ETML-ES-SLO/PRJ_2409_Surveillance_T_H_Frigo/doc/Annexes/Annexes non triés/Annexe K à N.pdf

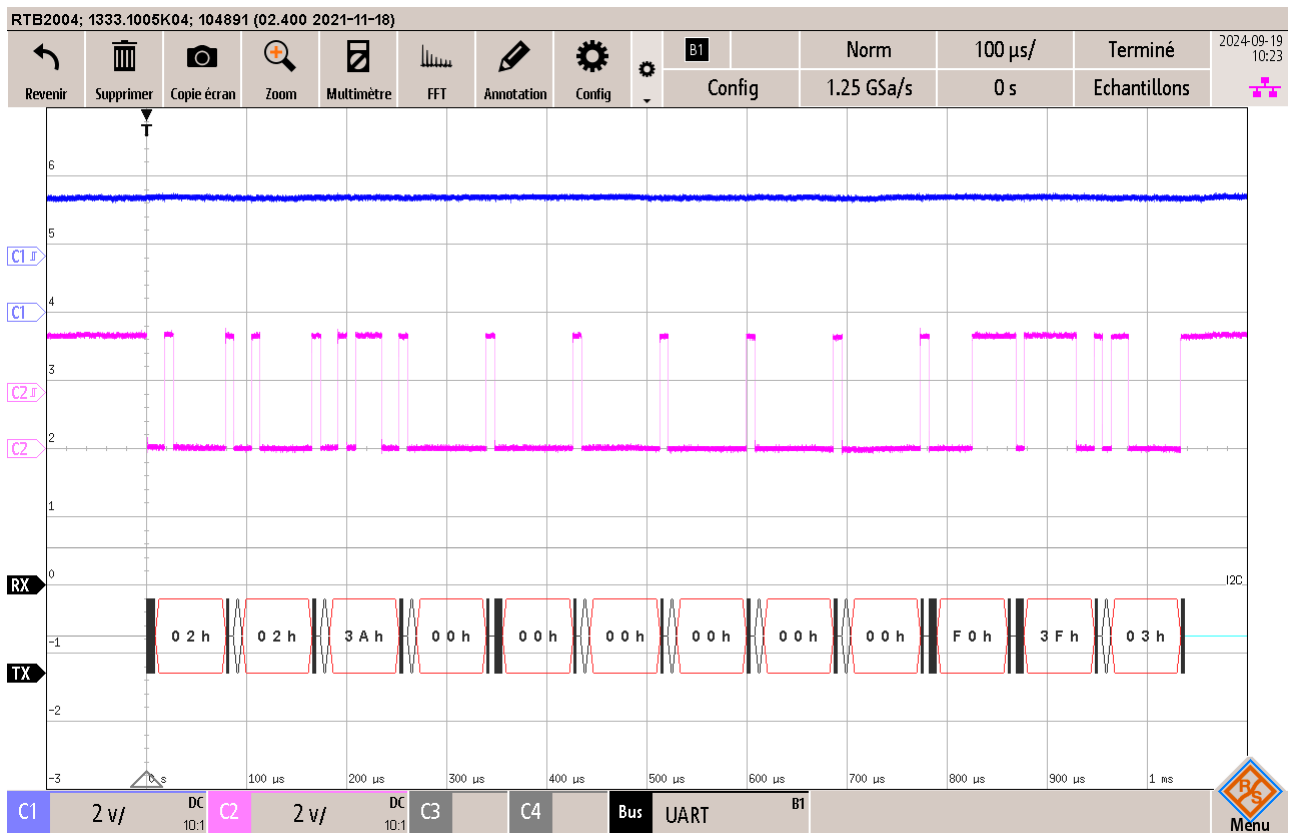
[picture p62: figure]

Page 1 sur 8

## Annexe K Liste de matériel

## Annexe L

## L.1 UART

Figure 1 Envoie trame du serveur au STM32, modification index 2 à 1[°C]

Désignation | Marque | Type | Caractéristique | N° d’inventaire
G1 | GwINSTEK | GPS-3303 | Alimentation | ES. SLO2. 00.00.26
P1 | GwINSTEK | GDM-396 | Multimètre | ES. SLO2.00.00.93
P2 | Rohde & Schwarz | RTB2004 | Oscilloscope | ES. SLO2.05.01.06
X1 | - | - | PCB 2409 | 2409
X2 | DELL | - | Ordinateur | SLO-R110-M306
- | Cisco | WRVS4400N V2 | Routeur | -

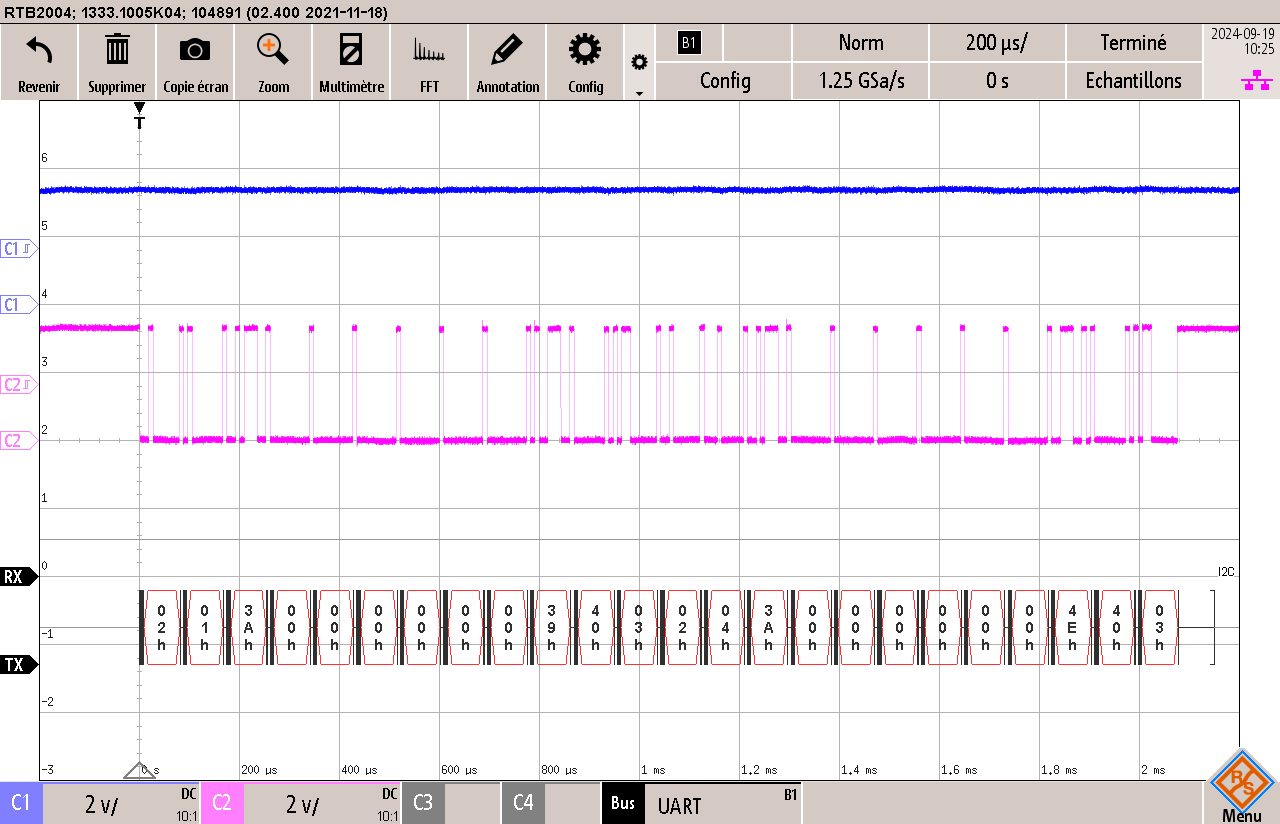
[picture p63: figure]

Page 2 sur 8

Figure 2 Envoi trame du serveur au STM32, modification index 3 à 35[%]

Figure 3 Envoi trame du serveur au STM32, modification index 1 et 4 à 25[°C] et 60[%]

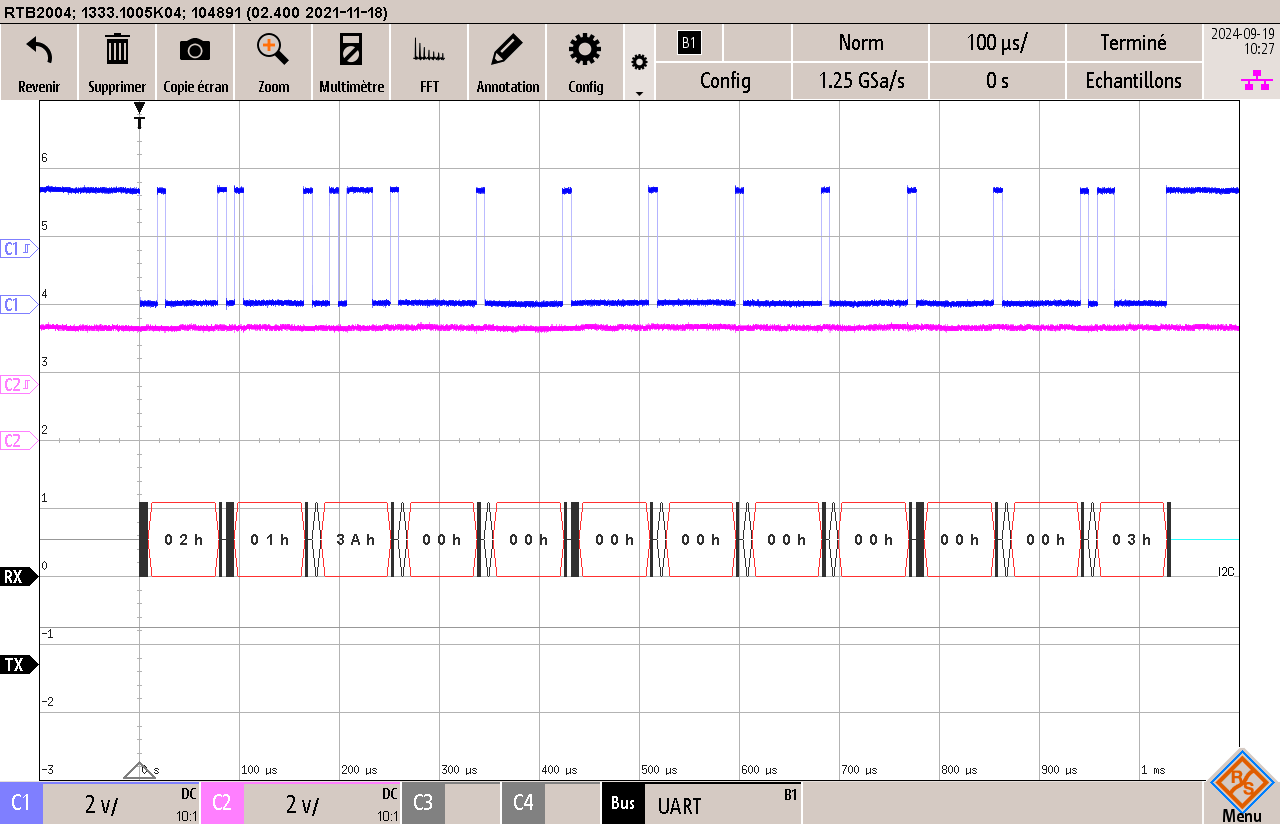
[picture p64: figure]

Page 3 sur 8

Figure 4 Envoi Alarme au serveur

Figure 5 Envoi Piles ok au serveur

## L.2 SPI

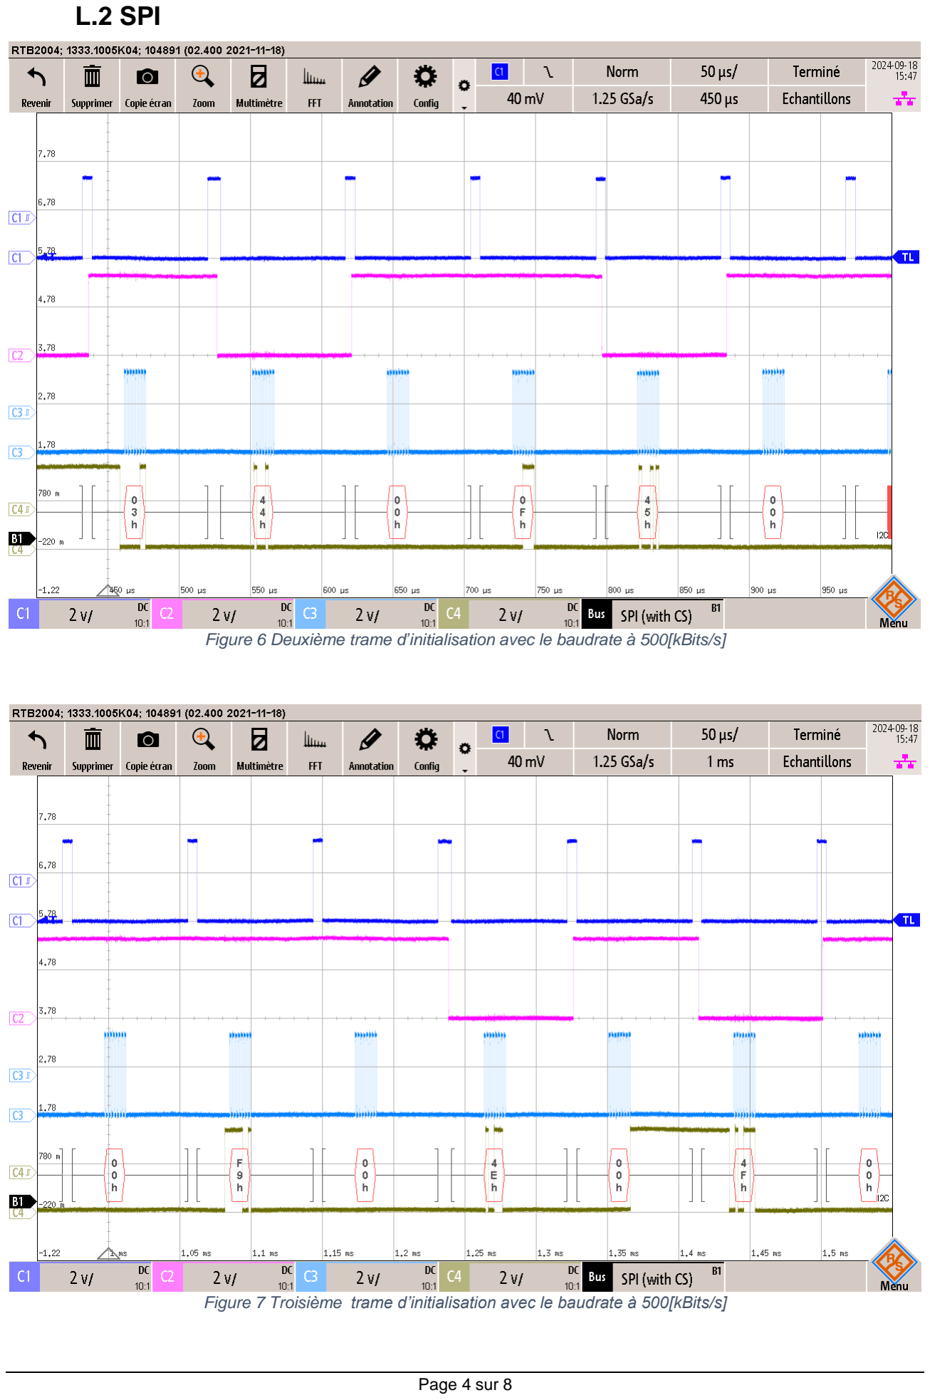
[picture p65: page 4]

Page 4 sur 8

Figure 6 Deuxième trame d’initialisation avec le baudrate à 500[kBits/s]

Figure 7 Troisième trame d’initialisation avec le baudrate à 500[kBits/s]

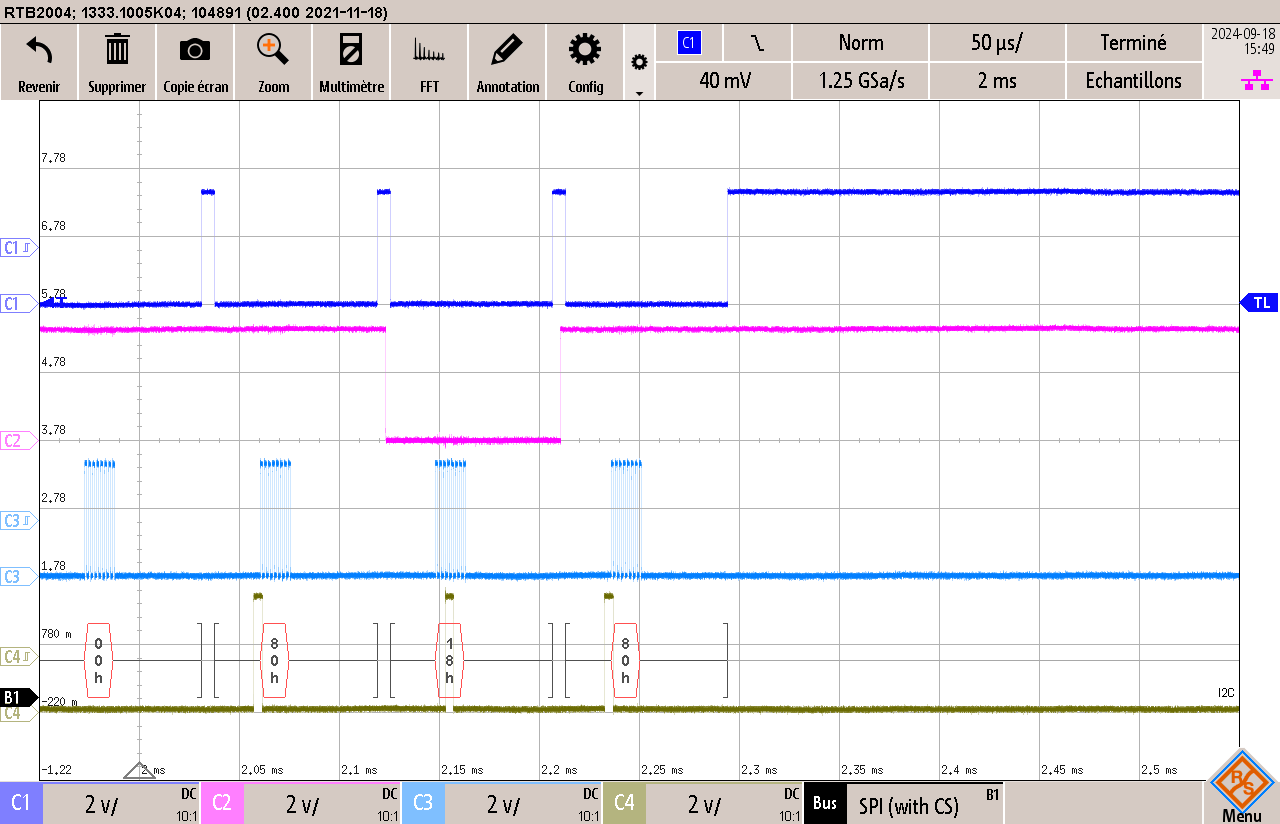
[picture p66: figure]

Page 5 sur 8

Figure 8 Quatrième trame d’initialisation avec le baudrate à 500[kBits/s]

Figure 9 Dernière trame d’initialisation avec le baudrate à 500[kBits/s]

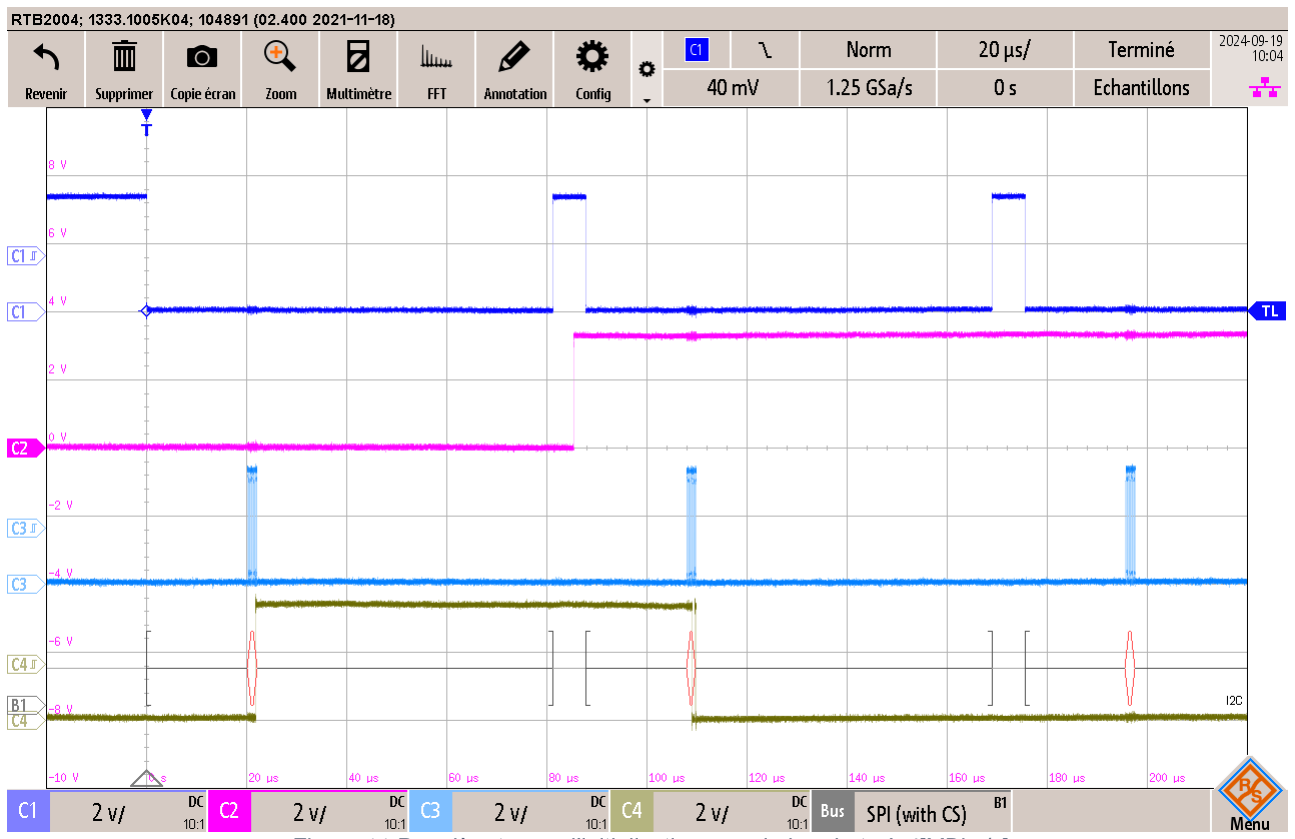
[picture p67: figure]

Page 6 sur 8

Figure 10 Durée d'une trame SPI

Figure 11 Première trame d’initialisation avec le baudrate à 4[MBits/s]

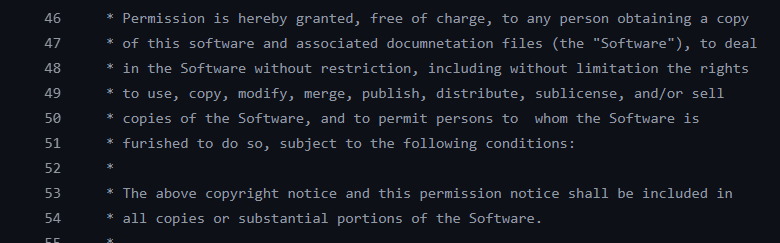
[picture p68: figure]
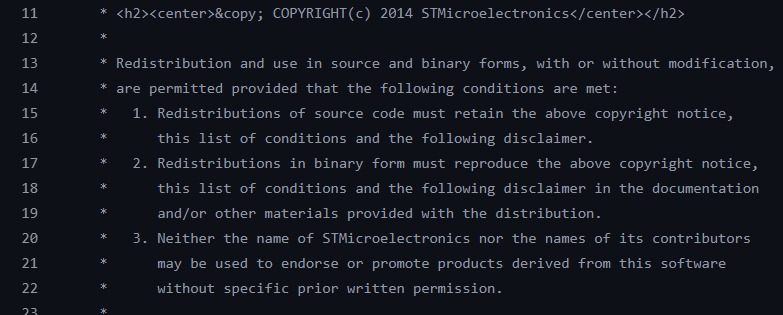
[picture p69: figure]

Page 7 sur 8

## Annexe M Librairies GitHub utilisées

Nom de la bibliothèque | Rôle dans le projet | Lien GitHub | Auteur | Licence
Waveshare e-Paper STM32 | Gestion de l’affichage e-paper dans le projet | https://github.com/waveshareteam/e-Paper/tree/master/STM32 (https://github.com/waveshareteam/e-Paper/tree/master/STM32) | Waveshare | Non indiquée*
Stm32-hal-libraries | Gestion capteur de température et humidité | https://github.com/belyalov/stm32-hal-libraries/tree/master | belyalov | MIT**

*Remarque : WaveShare n’indique pas de licence explicite pour l’ensemble du projet dans le dépôt principal. Cependant dans la plupart des fichiers, source ou header, un texte de permission est inclus, permettant l’utilisation, la modification et la distribution du code sous certaines conditions :

Figure 12 Permission WaveShare

Certains fichiers contiennent une permission différente :

Figure 13 Permission différente

** La licence MIT (Massachusetts Institute of Technology License), accorde un droit illimité d’utiliser, copier, modifier et distribuer le logiciel, à condition de conserver les mentions de copyright.

Page 8 sur 8

## Annexe N Installations liées à Arduino IDE

Nom | Rôle dans le projet | Auteur | Ou
Esp32 | Prise en charge de l’ESP32 | Espressif Systems | Tools -> Board -> Manage librairies
Arduino_JSON | Manipulation et traitement des données reçues depuis le serveur | Arduino | Sketch -> Include Library-> Manage librairies
Usini_discord_webHook | Envoi de notification Discord lors d’un seuil dépassé | Usini | Sketch -> Include Library-> Manage librairies
