ETML-ES-SLO/PRJ_2409_Surveillance_T_H_Frigo/doc/Annexes/Annexes non triés/Annexe R_Flash ESP32 pour AT commandes.pdf

Mélissa Perret | 2409_MesureTH

## Annexe R Flash ESP32 pour AT commandes

### 1. Instructions pour flash l’ESP32 pour les AT commandes

### 1.1 Téléchargement des drivers

1. Télécharger le programme ESP-AT¹
(« v3.3.0.0 ESP32-C3-MINI-1-AT-V3.3.0.0.zip (https://dl.espressif.com/esp-at/firmwares/esp32c3/ESP32-C3-MINI-1-AT-V3.3.0.0.zip) » ou la version recommandée), puis le décompresser
2. Télécharger l’outil de programmation :

Figure 1 Logiciel de programmation²

### 1.2 Schéma de programmation

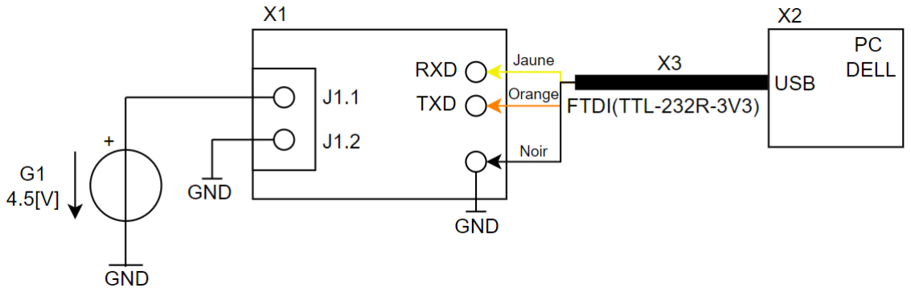
[picture p88: figure]

Figure 2 Schéma pour programmer l'ESP32

### 1.3 ESP en mode téléchargement

1. Brancher la carte selon le schéma de la figure 2
2. Ouvrir le gestionnaire de périphériques Windows
3. Récupérer le nom du port COM
4. Ouvrir PuTTY

1 Espressif. « Released Firmware », [en ligne], (consulté le 22 septembre 2024), master(latest), , ESP32-C3-
MINI-1 | Series. | URL : | https://docs.espressif.com/projects/esp-
at/en/latest/esp32c3/AT_Binary_Lists/esp_at_binaries.html (https://docs.espressif.com/projects/esp-at/en/latest/esp32c3/AT_Binary_Lists/esp_at_binaries.html)
2 Espressif. « Download », [en ligne], (consulté le 22 septembre 2024), master(latest), Flash Download Tools. URL: https://www.espressif.com/en/support/download/other-tools

5. Dans PuTTY, sous Connection -> Serial, configurer les paramètres suivants :
- COM18 ou celui relevé dans le gestionnaire de périphérique
- Speed: 115200
- Data bits: 8
- Stop bits: 1
- Parity: None
- Flow Control: XON/XOFF
6. Cliquer sur le bouton Open
7. Maintenir le bouton SW3
8. Appuyer sur le bouton SW2
9. Le message suivant devrait apparaître :

Figure 3 Message indiquant que l'ESP32 est passé en mode download

10.Fermer PuTTY

### 1.4 Programmation de l’ESP32

1. Ouvrir l’outil de programmation téléchargé précédemment (figure 1)
2. Sélectionner dans la configuration :
- ChipType: ESP32-C3
- WorkMode: Develop
- LoadMode: UART
3. Appuyer sur le bon OK
4. Une fois ouvert, sélectionner la configuration suivante :

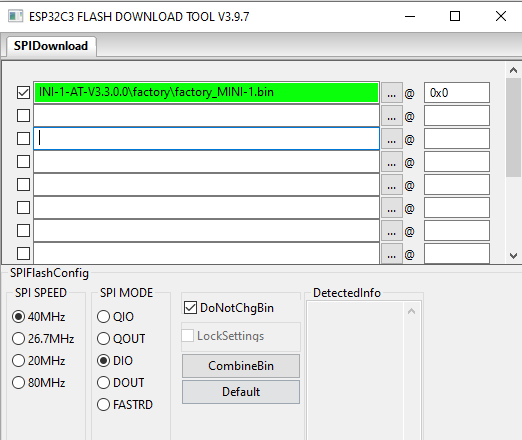
[picture p89: figure]

Figure 4 Configuration du logiciel

3. Cocher la première ligne comme la figure 4, puis dans les « … », ajouter le fichier nommé « factory_Mini-1.bin » dans le dossier « factory » du dossier « ESP32-C3-MINI-1-AT-V3.3.0.0 »
4. Mettre la valeur à 0x0 dans la colonne de droite
5. Cocher « DoNotChgBin »
6. Mettre le port COM
7. Mettre 115200 dans BAUD
8. Appuyer sur START
9. Attendre l’affichage suivant :

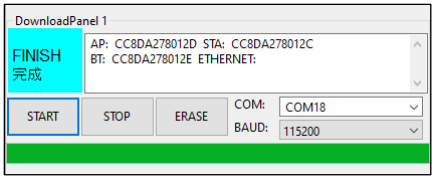
[picture p90: figure]

Figure 5 fin de programmation

### 1.5 Vérification de la programmation

1. Ouvrir PuTTY et régler les mêmes paramètres que précédemment (voir point 1.3, point 5)
2. Cliquer sur Open
3. Appuyer sur le bouton SW2
4. Si l’ESP32 est bien programmé, le message suivant apparaît :

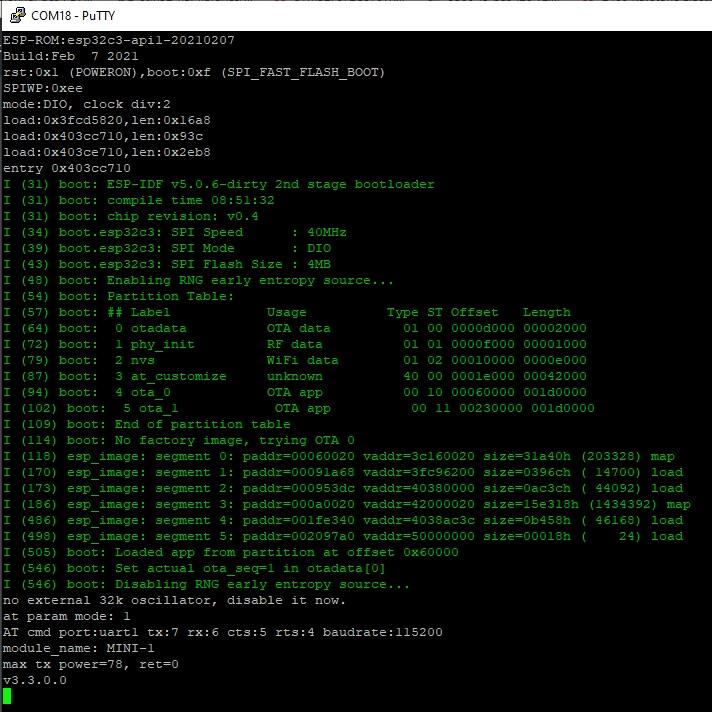
[picture p91: figure]

Figure 6 Vérification de programmation de l'ESP
