ETML-ES-SLO/PRJ_2409_Surveillance_T_H_Frigo/doc/Annexes/Annexes non triés/Annexe S/Annexe S.11 mesures source.pdf

K:\ES\PROJETS\SLO\2409_MesureTH_RefrigerateurCongelateur\soft\Firmware\STM32\2409_MesureTH_V1\2409_MesureTH_V1\Mesures\mesures.c

### Page 1

1 // mesures.c
2 //
3 // Description : fonctions liées aux mesures de la sonde (température et humidté) 4 // Auteur : Perret Mélissa
5 // Création : 16/09/2024
6 // Modifications : --
7
8 | // Version | : V1.0
9 /*--------------------------------------------------------*/ 10
11
12 #include "mesures.h"
13 #include "shtc3.h" // pour utiliser la sonde
14
15
16 //// Fonction EffectuerMesuresSonde (mesure témparture et humidité)
17 //// Description: mesure témparture et humidité
18 | //// | vérification dépassement des seuils
19 | //// | en cas de changement d'état, demande rafraichissement écran et l'envoie de la trame UART
20 //// Entrées: Pointeur:I2C_HandleTypeDef hi2c2, Pointeur:Mesures mesures, Tableau:DefinitionValeur valeursServeur 21 //// Sorties: Etat (état de l'alarme liée au dépassement des seuils)
22 Etat EffectuerMesuresSonde(I2C_HandleTypeDef* hi2c2, Mesures* mesures, DefinitionValeur valeursServeur[])
23 {

### 24 if (shtc3_read_id(hi2c2)) // Si on détecte la sonde

25 {
26 // Effectuer les mesures
27 if (shtc3_perform_measurements(hi2c2, &mesures->temperatureEntierActuelle, &mesures->humiditeEntierActuelle)) // Si la mesure est réussie 28 {
29 // Les résultats de la sonde sont transmis sous forme d'entier
30 // Il s'agit en réalité de la valeur avec deux décimales, remis sous forme d'entier en étant multiplié par 100
31 // On effectue l'opération inverse (division par 100) pour récupérer la valeur décimale
32 mesures->temperatureActuelle = (float)mesures->temperatureEntierActuelle/100;
33 mesures->humiditeActuelle = (float)mesures->humiditeEntierActuelle/100;
34
35 // Pour éviter de rafraichisr l'écran E-paper trop souvent, on mesure l'écart entre la nouvelle valeur et la dernière valeur affiché 36 // Si l'écart est supérieur à l'écart minimal on demandera le rafraichissement de l'écran
37 // Les valeurs des écarts est transmises par le serveur
38
39 // Ecart température
40 double ecartTemperatureMinimal = valeursServeur[ECART_TEMPERATURE].valeur; // Ecart minimal de temperature pour effectuer un rafraichissement du E-paper
41 float ecartTemperature = mesures->temperatureActuelle - mesures->temperatureAffichee; // Ecart entre la température mesurée et la température affichée
42 if(ecartTemperature >= ecartTemperatureMinimal || ecartTemperature <= -ecartTemperatureMinimal) // Si l'écart est plus important que l'écart minimal
43 {

### 44 rafraichirEPaper = true; // Indiquer qu'un rafraichissement de l'écran est nécessaire

45 }
46
47 // Ecart humidité
48 double ecartHumiditeMinimal= valeursServeur[ECART_HUMIDITE].valeur; // Ecart minimal d'humidité pour effectuer un rafraichissement du E-paper 49 float ecartHumidite = mesures->humiditeActuelle - mesures->humiditeAffichee; // Ecart entre l'humidité mesurée et l'humidité affichée
50 if(ecartHumidite >= ecartHumiditeMinimal || ecartHumidite <= -ecartHumiditeMinimal) // Si l'écart est plus important que l'écart minimal

K:\ES\PROJETS\SLO\2409_MesureTH_RefrigerateurCongelateur\soft\Firmware\STM32\2409_MesureTH_V1\2409_MesureTH_V1\Mesures\mesures.c

### Page 2

51 {

### 52 rafraichirEPaper = true; // Indiquer qu'un rafraichissement de l'écran est nécessaire

53 }
54
55 // Vérification dépassement des seuils (pour définir le nouvel état de l'alarme dépassement des seuils)
56 bool depassementTemperature = mesures->temperatureActuelle < valeursServeur[SEUIL_TEMPERATURE_MIN].valeur || mesures->temperatureActuelle > valeursServeur[SEUIL_TEMPERATURE_MAX].valeur;
57 bool depassementHumidite = mesures->humiditeActuelle < valeursServeur[SEUIL_HUMIDITE_MIN].valeur || mesures->humiditeActuelle > valeursServeur[SEUIL_HUMIDITE_MAX].valeur;
58 Etat nouvelEtatSeuils = INDEFINI;

### 59 if(depassementTemperature || depassementHumidite)

60 {
61 nouvelEtatSeuils = ALARME; // Dépassement des seuils min/max (température et/ou humidité) 62 }

### 63 else

64 {
65 nouvelEtatSeuils = OK; // Pas de dépassement des seuils min/max (température et humidité) 66 }
67
68 // Code de test qui change l'état de l'alarme dépassement des seuils à chaque réveil
69 // Permet de tester l'envoi des trames vers l'ESP

### 70 if(DEBUG_ALARME_SEUILS)

71 {

### 72 if(mesures->etatSeuils == ALARME) // Si l'état était ALARME on passe en OK

73 {
74 nouvelEtatSeuils = OK;
75 }

### 76 else

77 {

### 78 nouvelEtatSeuils = ALARME; // Si l'état n'était pas ALARME on passe en ALARME

79 }
80 }
81
82 return nouvelEtatSeuils; 83 }

### 84 else

85 {

### 86 return mesures->etatSeuils; // Mesure impossible, pas de changement d'état

87 }
88 }

### 89 else

90 {

### 91 return mesures->etatSeuils; // Mesure impossible, pas de changement d'état

92 }
93 }
94
