ETML-ES-SLO/PRJ_2409_Surveillance_T_H_Frigo/doc/Annexes/Annexes non triés/Annexe S/Annexe S.7 fonctionADC source.pdf

K:\ES\PROJETS\SLO\2409_MesureTH_RefrigerateurCongelateur\soft\Firmware\STM32\2409_MesureTH_V1\2409_MesureTH_V1\ControlePiles\fonctionsADC.c

### Page 1

1 // fonctionsADC.c
2 //
3 // Description : fonctions liée à l'ADC 4 // Auteur : Perret Mélissa
5 // Création : 09/05/2024
6 // Modifications : --
7
8 | // Version | : V1.0
9 /*--------------------------------------------------------*/
10
11 //----------------------CONFIGURATION UART HARMONY----------------------------// 12 /*
13 * Activer le UART -> CubeMX
14 * Régler le BaudRate @ 9600 (comme signalé dans le datasheet)
15 * Activer 8 bits de data, aucune parité et 1 bit de stop
16 * Pamamètrer l'over Yampling à 16
17 * Activer le control de flux
18 */
19
20 #include "fonctionsADC.h"
21
22 //// Fonction LectureValeurAdcBrute (lecture de registre du ADC)
23 //// Description: lire la valeur brute de l'adc en fonction du channel
24 //// Entrées: Pointeur:ADC_HandleTypeDef hadc, uint8_t channel (numéro de channel à utiliser pour l'ADC) 25 //// Sorties: uint16_t (valeur brute de l'ADC, valeur comprise entre 0 à 4095)

### 26 uint16_t LectureValeurAdcBrute(ADC_HandleTypeDef* hadc, uint8_t channel)

27 {

### 28 HAL_ADC_Stop(hadc); // Arrêt de l'ADC

29
30 HAL_StatusTypeDef calibrationStatus = HAL_ADCEx_Calibration_Start(hadc); // Nouvelle calibration par précaution 31

### 32 hadc->Instance->CHSELR = 1 << channel; // Sélection du bon channel

33

### 34 HAL_StatusTypeDef adcStatus = HAL_ADC_Start(hadc); // Démarrage de l'ADC

35
36 // Realise une mesure du registre de l'ADC, sort de la fonction après un certain temps si pas possible (TIMEOUT_LECTURE_ADC_MS) 37 while (HAL_ADC_PollForConversion(hadc, TIMEOUT_LECTURE_ADC_MS) != HAL_OK) // Attente fin de conversion
38 {
39 }
40

### 41 uint32_t mesure = 0; // Déclaration variable locale (valeur mesurée) 42 mesure = HAL_ADC_GetValue(hadc); // Sauvegarde de la mesure

43

### 44 HAL_ADC_Stop(hadc); // Arrêt de l'ADC

45

### 46 return mesure; // Retourne la valeur brute mesurée

47 }
48
49 //// Fonction ConversionValeurAdcEnVolt: conversion d'une valeur brute ADC en une tension
50 //// Description: conversion d'une valeur brute ADC (0 à 4095) en une tension (en Volt)
51 //// Entrées: uint16_t valeurADC (valeure brute ADC à convertir),
52 | //// | uint32_t pontDiviseurResistanceHaute (valeur de la resistance en haut dans le pont diviseur de tension)
53 | //// | uint32_t pontDiviseurResistanceBasse (valeur de la resistance en bas dans le pont diviseur de tension)

K:\ES\PROJETS\SLO\2409_MesureTH_RefrigerateurCongelateur\soft\Firmware\STM32\2409_MesureTH_V1\2409_MesureTH_V1\ControlePiles\fonctionsADC.c

### Page 2

54 //// Sorties: float (valeur brute de l'ADC convertie en valeure tension)
55 float ConversionValeurAdcEnVolt(uint16_t valeurADC, uint32_t pontDiviseurResistanceHaute, uint32_t pontDiviseurResistanceBasse)
56 {
57 // Rappels ponts diviseur de tension:
58 // Vout = (Vin * R2) / (R1 + R2)
59 // Vin = (Vout / R2) * (R1 + R2)
60
61 uint32_t R1 = pontDiviseurResistanceHaute; // Plus simple pour lire le code qui suit (formules)
62 uint32_t R2 = pontDiviseurResistanceBasse; // Plus simple pour lire le code qui suit (formules)
63
64 float valeurAdcEnVolt = valeurADC * VREF_ADC_V / VAL_ADC_MAX; // Correspond au Vout du pont diviseur de tension 65 return valeurAdcEnVolt * (R1 + R2) / R2; // Prise en compte du pont diviseur de tension pour retrouver le Vin 66 }
67
