ETML-ES-SLO/PRJ_2409_Surveillance_T_H_Frigo/doc/Annexes/Annexes non triés/Annexe T/Annexe T.11_Sommeil.ino.pdf

1 // Sommeil.ino
2 //
3 // Description : fonctions liées à l'entrée et la sortie du mode sommeil 4 // Auteur : Perret Mélissa
5 // Création : 22/09/2024
6 // Modifications : --
7
8 | // Version : V1.0
9 /*--------------------------------------------------------*/ 10
11
12 #include "Sommeil.h"
13
14
15 //// Fonction EntreeModeSommeilProfond: logique pour entrer en mode sommeil profond 16 //// Description: active les conditions de réveil (pin pour permettre le réveil depuis le STM, et timer pour le prochain réveil) et rentre en mode sommeil profond 17 //// Entrées: -
18 //// Sorties: -
19 void EntreeModeSommeilProfond() {
20
21 // Activation réveil possible via GPIO 22 const gpio_config_t config = {
23 .pin_bit_mask = BIT(PIN_REVEIL_PAR_STM),
24 .mode = GPIO_MODE_INPUT,
25 };
26 ESP_ERROR_CHECK(gpio_config(&config)); // Pour configurer la pin de réveil 27 ESP_ERROR_CHECK(esp_deep_sleep_enable_gpio_wakeup(BIT(PIN_REVEIL_PAR_STM), ESP_GPIO_WAKEUP_GPIO_HIGH)); // Pour indiquer la pin permettant de sortir du mode sommeil (Permet au STM de réveiller l'ESP si besoin)
28
29 // http://esp-idf.readthedocs.io/en/latest/api-reference/system/deep_sleep.html 30 esp_sleep_enable_timer_wakeup(DUREE_SOMMEIL_MS * CONVERSION_MS_EN_uS); // Pour indiquer le délai avant de sortir du mode sommeil (si l'on est pas réveillé avant via la pin)
31
32 if (MODE_DEBUG) {
33 printf("Entree en mode sommeil pendant %d ms (ou via réveil STM pin GPIO%d)\n", DUREE_SOMMEIL_MS, PIN_REVEIL_PAR_STM); 34 }
35
36 //
https://docs.espressif.com/projects/esp-idf/en/stable/esp32/api-reference/system/sleep_modes.html
37 //esp_deep_sleep_pd_config(ESP_PD_DOMAIN_RTC_PERIPH, ESP_PD_OPTION_OFF); 38 esp_deep_sleep_start(); // Pour entrer en mode sommeil profond
39 }
40
41
42 //// Fonction GestionReveil: logique exécutée au moment du réveil
43 //// Description: détermine la raison du réveil (lancement, STM ou timer), lance l'exécution de la logique correspondante au type de réveil
44 //// Entrées: -
45 //// Sorties: -
46 void GestionReveil() {
47 esp_sleep_wakeup_cause_t raisonReveil; // Déclaration variable locale
48 raisonReveil = esp_sleep_get_wakeup_cause(); // Pour obtenir la raison du réveil 49 if (MODE_DEBUG) {
50 printf("\nRaison du réveil: %d\n", raisonReveil);
51 }
52
53 // Si la raison du réveil est inconnue, c'est qu'il s'agit du premier démarrage de l'ESP
54 if (raisonReveil == ESP_SLEEP_WAKEUP_UNDEFINED) {
55 if (MODE_DEBUG) {
56 printf("Initialisation au premier réveil\n"); 57 }
58
59 // Initialisation au premier réveil
60 // On met des valeurs incohérentes pour s'assurer que les premières valeurs qui seront reçues du serveur seront considérées comme différentes 61 valeursServeur[0] = -9999;
62 valeursServeur[1] = -9999;

63 valeursServeur[2] = -9999; 64 valeursServeur[3] = -9999; 65 valeursServeur[4] = -9999; 66 valeursServeur[5] = -9999; 67
68 ExecutionReveilTimer();
69 } else {
70 // Si la raison du réveil provient de la pin GPIO, c'est que l'ESP a été réveillé par le STM
71 if (raisonReveil == ESP_SLEEP_WAKEUP_GPIO) {
72 if (MODE_DEBUG) {
73 printf("Réveil causé par le STM (trames UART à réceptionner)\n"); 74 }
75
76 ExecutionReveilSTM();
77 } else {
78 // ESP réveillé par le timer
79 if (MODE_DEBUG) {
80 printf("Réveil causé par le timer\n"); 81 }
82
83 ExecutionReveilTimer();
84 }
85 }
86 }
