ETML-ES-SLO/PRJ_2409_Surveillance_T_H_Frigo/doc/Annexes/Annexes non triés/Annexe T/Annexe T.4_CommunicationSTM.h.pdf

1
2 /* ************************************************************************** */ 3 /** Descriptive File Name
4
5 @Company
6 ETML-ES
7
8 @File Name
9 CommunicationSTM.h
10
11 @Auteurs
12 - Perret Mélissa
13
14 @Description
15 Fonctions liées à la communication entre l'ESP et le STM
16 */
17 /* ************************************************************************** */ 18
19
20 #ifndef _COMMUNICATION_STM_H
21 #define _COMMUNICATION_STM_H
22
23
24 #include "driver/uart.h" // pour UART_NUM_0
25 | #include <HTTPClient.h> // pour HTTPClient
26
27
28 #define TXD_PIN (GPIO_NUM_7) // PIN utilisée pour écrire les trames UART
29 #define RXD_PIN (GPIO_NUM_6) // PIN utilisée pour lire les trames UART
30
31 #define PIN_POUR_REVEILLER_STM GPIO_NUM_5 // PIN utilisée pour réveiller le STM (état haut) et pour indiquer quand l'ESP à fini de transmettre ses trames UART (état bas)
32
33 #define UART_RECEPTION_TIMEOUT_MS 100 // Timeout lors de la réception UART
34
35 | const uart_port_t uart_num = UART_NUM_0; // UART utilisé
36 | const size_t TAILLE_BUFFER = 50; // Taille du tableau utilisé pour
stocker les données UART reçues
37 uint8_t receptionTramesUART[TAILLE_BUFFER]; // Tableau pour stocker les données UART reçues
38
39 // Enumération pour représenter le type de valeur reçu par le STM et améliorer la lisibilité du code
40 typedef enum {
41 ETAT_SEUILS,
42 ETAT_BATTERIE,
43 } ValeursSTM;
44
45 // Enumération pour représenter les états reçus par le STM (alarme seuils ou batterie) et améliorer la lisibilité du code
46 typedef enum {
47 FONCTIONEL, // 0
48 | ALARME, // 1
49 | IDENTIQUE, // 2
50 } Etat;
51
52 // Structure pour stocker les valeurs liées au STM (alarme seuils et etat batterie) 53 typedef struct {
54 String nom;
55 double valeur;
56 } ValeurSTM;
57
58 // Valeurs liées au STM (alarme seuils et etat batterie) 59 ValeurSTM valeursSTM[] = {
60 { "alarme", -9999 },
61 { "pilesFaibles", -9999 },
62 };
63
64
65 #endif /* _COMMUNICATION_STM_H */
