ETML-ES-SLO/PRJ_2409_Surveillance_T_H_Frigo/doc/Annexes/Annexes non triés/Annexe T/Annexe T.7_ Discord.ino.pdf

1 // Discord.ino
2 //
3 // Description : fonctions liées à l'envoi de notifications Discoprd 4 // Auteur : Perret Mélissa
5 // Création : 22/09/2024
6 // Modifications : --
7
8 | // Version : V1.0
9 /*--------------------------------------------------------*/ 10
11 #include "Discord.h"
12 #include <WiFiClientSecure.h> // pour envoyer notifications
13 | #include <HTTPClient.h> // pour HTTPClient
14
15
16 // Code provenant initialement de la libraiie Discord_WebHook : // https://github.com/usini/usini_discord_webhook/tree/main
17 // La librairie ne fonctionnait pas (erreur de compilation lié à un mauvais #include) 18 // Pour régler le problème, le code principal de la librairie à été directmeent intégré dans le projet
19 // Les fichiers originaux de la libraire (ainsi que la licence) sont inclus dans le dossier du projet.
20
21
22 //// Fonction EnvoyerNotificationsDiscord: gère l'envoie des notifications Discord (état batterie et état seuils alarme)
23 //// Description: gère l'envoie des notifications Discord (état batterie et état seuils alarme)
24 //// Entrées: Pointeur:HTTPClient http
25 //// Sorties: -
26 void EnvoyerNotificationsDiscord(HTTPClient* http) { 27
28 // Traitement état batterie
29 switch ((Etat)valeursSTM[ETAT_BATTERIE].valeur) {
30 case FONCTIONEL:
31 EnvoyerNotificationDiscord(http, false, "Charge OK");
32 break;
33 case ALARME:
34 EnvoyerNotificationDiscord(http, false, "Charge faible !"); 35 break;
36 case IDENTIQUE:
37 break;
38 }
39
40 // Traitement alarme seuils
41 switch ((Etat)valeursSTM[ETAT_SEUILS].valeur) {
42 case FONCTIONEL:
43 EnvoyerNotificationDiscord(http, false, "Seuils OK");
44 break;
45 case ALARME:
46 EnvoyerNotificationDiscord(http, false, "Alarme seuils !"); 47 break;
48 case IDENTIQUE:
49 break;
50 }
51 }
52
53 //// Fonction EnvoyerNotificationDiscord: gère l'envoie d'une notifications Discord (text passé en paramètre d'entreé)
54 //// Description: gère l'envoie des notifications Discord (état batterie et état seuils alarme)
55 //// Entrées: Pointeur:HTTPClient http (client http utilisé pour effectuer la requête)
56 | //// bool syntheseVocale (indique si la synthèse vocale pour le message est
activé, pour permettre aux utilisés d'utilité la synthèse vocale d'entendre le message).
57 | /// String message (text à envoyer dans Discord)
58 //// Sorties: bool (indique si la notification à bien été envoyée)
59 bool EnvoyerNotificationDiscord(HTTPClient* http, bool syntheseVocale, String message) {
60
61 String discord_tts = "false";
62 if (syntheseVocale) {
63 discord_tts = "true";

64 }
65
66 // Utilisation de WiFiClientSecure pour pouvoir créer une requête HTTPS 67 WiFiClientSecure* client = new WiFiClientSecure;
68 bool ok = false;
69 if (client) {
70 client->setInsecure(); // Désactiver la vérification certificat SSL 71
72 if (MODE_DEBUG) {
73 printf("[HTTP] Connexion à Discord...\n");
74 printf("[HTTP] Message: %s\n", message.c_str());
75 printf("[HTTP] Synthèse Vocale: %s\n", discord_tts.c_str()); 76 }
77
78 // Débuter requête HTTPS
79 if (http->begin(*client, DISCORD_WEBHOOK_URL)) { // pour indiquer le début de la communication HTTP

### 80 http->addHeader("Content-Type", "application/json"); // Définir la requête

sous forme de JSON
81
82 // Envoyer la requête POST
83 int httpCode = http->POST("{\"content\":\"" + message + "\",\"tts\":" + discord_tts + "}");
84 if (httpCode > 0) { // Si un code HTTP code est renvoyé
85 if (httpCode == HTTP_CODE_OK || httpCode == HTTP_CODE_MOVED_PERMANENTLY || httpCode == HTTP_CODE_NO_CONTENT) { 86 // https://support.discord.com/hc/en-us/articles/228383668-Intro-to-Webhooks 87 if (MODE_DEBUG) {
88 printf("[HTTP] OK\n");
89 }
90 ok = true;
91 } else {
92 if (MODE_DEBUG) {
93 // Erreur
94 printf("[HTTP] ERREUR: %s\n", http->getString().c_str()); 95 ok = false;
96 }
97 }
98 } else {
99 if (MODE_DEBUG) {
100 // Serveur non accessible
101 printf("[HTTP] ERREUR: %s\n", http->errorToString(httpCode).c_str()); 102 ok = false;
103 }
104 }
105 } else {
106 if (MODE_DEBUG) {
107 // Echec de la requête
108 printf("[HTTP] Connexion impossible\n"); 109 ok = false;
110 }
111 }
112 http->end(); // pour indiquer la fin de la communication HTTP 113 } else {
114 if (MODE_DEBUG) {
115 printf("[HTTP] Impossible de creer client\n");
116 ok = false;
117 }
118 }
119 delete client;
120 return ok;
121 }
