ETML-ES-SLO/PRJ_2409_Surveillance_T_H_Frigo/doc/Annexes/Annexes non triés/Annexe T/Annexe T.8_ Execution.ino.pdf

1 // Execution.ino
2 //
3 // Description : fonctions liées à l'exécution principale de la logique de l'ESP 4 // Auteur : Perret Mélissa
5 // Création : 22/09/2024
6 // Modifications : --
7
8 | // Version : V1.0
9 /*--------------------------------------------------------*/ 10
11
12 #include "Execution.h"
13 | #include "Wifi.h" // pour wifiMulti
14 #include "Sommeil.h" // pour PIN_REVEIL_PAR_STM
15
16
17 //// Fonction ExecutionReveilTimer: logique princiaple de l'ESP lorsqu'il est reveillé par le timer
18 //// Description: connexion Wifi, réveiller le STM, récupéreration et transmissions des valeurs du serveur, envoie notification Discord, retour en mode sommeil
19 //// Entrées: -
20 //// Sorties: -
21 void ExecutionReveilTimer() {
22
23 // connexion WiFi
24 if ((wifiMulti.run() == WL_CONNECTED)) { 25
26 HTTPClient http;
27
28 if (MODE_DEBUG) {
29 printf("[HTTP] begin...\n");
30 }
31
32 http.begin(SERVEUR_ADDRESSE_HTTP); // pour indiquer le début de la communication HTTP
33
34 ReveillerSTM();
35 delay(DELAI_TRANSMISSION_STM_MS); // pour s'assurer que le STM soit bien prêt à recevoir les trames UART
36
37 ReceptionServeur(&http); // réception et traitement des données du serveur
38
39 EnvoyerSignalFinSTM(); // indiquer au STM que l'ESP à fini d'envoyer ses éventuelles trames UART
40
41 // considérer les valeurs du STM comme non changées avant de recevoir les éventuels changements de la part du STM 42 valeursSTM[ETAT_SEUILS].valeur = IDENTIQUE;
43 valeursSTM[ETAT_BATTERIE].valeur = IDENTIQUE;
44 ReceptionSTM(&http);
45
46 EnvoyerNotificationsDiscord(&http); // envoyer les éventuelles notificartions Discord en cas de changements de valeurs de la part du STM 47
48 http.end(); // pour indiquer la fin de la communication HTTP
49 }
50
51 delay(DELAI_MODE_SOMMEIL_MS); // délai éventuel avant de passer en mode sommeil (par précautions)
52
53 EntreeModeSommeilProfond(); // entrer en mode sommeil
54 }
55
56 //// Fonction ExecutionReveilSTM: logique princiaple de l'ESP lorsqu'il est reveillé par le STM
57 //// Description: réception trames STM, envoie notification Discord, retour en mode sommeil
58 //// Entrées: -
59 //// Sorties: -
60 void ExecutionReveilSTM() {
61 // connexion WiFi
62 if ((wifiMulti.run() == WL_CONNECTED)) { 63

64 HTTPClient http;
65
66 if (MODE_DEBUG) {
67 printf("[HTTP] begin...\n");
68 }
69
70 http.begin(SERVEUR_ADDRESSE_HTTP); // pour indiquer le début de la communication HTTP
71
72 // marquer les valeurs du STM comme non changées avant de recevoir les éventuels changements de la part du STM 73 valeursSTM[ETAT_SEUILS].valeur = IDENTIQUE;
74 valeursSTM[ETAT_BATTERIE].valeur = IDENTIQUE;
75
76 // procéder à la réception des données UART tant que le STM ne nous indique pas qu'il a terminé d'envoyer d'éventuelles trames UART 77 do {
78 ReceptionSTM(&http);
79 | delay(DELAI_RECEPTION_STM_MS); // Délai entre deux essais
pour recevoir les trames UART attendues de la part du STM 80 } while (digitalRead(PIN_REVEIL_PAR_STM) == HIGH); // Attendre que le STM nous signale qu'il a terminé d'envoyer les trames UART
81
82 ReceptionSTM(&http); // Important de refaire une nouvelle réception de trames UART au cas où le STM aurait envoyé des trames juste avant d'indiquer le signal de fin de communication
83
84 EnvoyerNotificationsDiscord(&http); // envoyer les éventuelles notifications Discord en cas de changements de valeurs de la part du STM 85
86 http.end(); // pour indiquer la fin de la communication HTTP
87 }
88
89 delay(DELAI_MODE_SOMMEIL_MS); // délai avant de passer en mode sommeil (par précautions)
90
91 EntreeModeSommeilProfond();
92 }
