ETML-ES-SLO/PRJ_2409_Surveillance_T_H_Frigo/doc/Annexes/Annexes non triés/Annexe Q_Calculs utilisés pour l’estimation de consommation  .pdf

ETML⁻ES | Section électronique Perret

Page 1 sur 1

### Annexe Q Calculs utilisés pour l’estimation de consommation

Délais entre deux réveils : 60[min]
Total heures mensuelle : 720[heures]
Durée réveil microcontrôleur : 5[s]
Nombre de rafraichissement e-paper par mois : 10 Durée rafraichissement : 3[s]

Calcul temps de réveil par mois en heures :

Durée réveil microcontrôleur ∙ 60 Délais entre deux réveils ∙

Total heures mensuelle
3600

Calcul temps de sommeil par mois en heures :

Total heures mensuelle − temps de réveil

Consommation moyenne en mA :

( Conso mode sommeil du composant ∙ Temps de sommeil par mois ) + ( Conso mode réveil du composant ∙ Temps de réveil par mois) Délais entre deux réveils
Autonomie :

Capacité en mA
Conso moyenne en mA ∙ 24
