ETML-ES-SLO/PRJ_2409_Surveillance_T_H_Frigo/doc/Annexes/Annexes non triés/Annexe T/Annexe T.10_Sommeil.h.pdf

1 /* ************************************************************************** */ 2 /** Descriptive File Name
3
4 @Company
5 ETML-ES
6
7 @File Name
8 Sommeil.h
9
10 @Auteurs
11 - Perret Mélissa
12
13 @Description
14 Fonctions liées à l'entrée et la sortie du mode sommeil
15 */
16 /* ************************************************************************** */ 17
18 #ifndef _SOMMEIL_H
19 #define _SOMMEIL_H
20
21
22 // Attention: DUREE_SOMMEIL_MS doit coincider avec la valeur de DELAI_ENTRE_DEUX_REVEILS_MS du côté du STM (gestionBatterie.h)
23 | #define DUREE_SOMMEIL_MS 5000 // Durée du mode sommeil de l'ESP en ms (quand il
n'est pas réveillé par le STM).
24 #define CONVERSION_MS_EN_uS 1000 // Facteur pour convertir des millisecondes en microsecondes
25
26 #define PIN_REVEIL_PAR_STM GPIO_NUM_4
27
28
29 #endif /* _SOMMEIL_H */
