ETML-ES-SLO/PRJ_2409_Surveillance_T_H_Frigo/doc/Annexes/Annexes non triés/Annexe T/Annexe T.13_Wifi.ino.pdf

1 // Wifi.ino
2 //
3 // Description : fonctions liées au Wifi 4 // Auteur : Perret Mélissa
5 // Création : 22/09/2024
6 // Modifications : --
7
8 | // Version : V1.0
9 /*--------------------------------------------------------*/ 10
11
12 #include "Wifi.h"
13
14
15 //// Fonction ConfigurerWifi: configuration de la connexion Wifi
16 //// Description: initie la connexion au réseau Wifi en utilisant le SSID et le mot de passe
17 //// Entrées: -
18 //// Sorties: -
19 void ConfigurerWifi() {
20 wifiMulti.addAP(WIFI_SSID, WIFI_MOT_DE_PASSE); // Connexion au réseau Wifi 21 }
