ETML-ES-SLO/PRJ_2409_Surveillance_T_H_Frigo/doc/Annexes/Annexes non triés/Annexe T/Annexe T.2_ CommunicationServeur.h.pdf

1 /* ************************************************************************** */ 2 /** Descriptive File Name
3
4 @Company
5 ETML-ES
6
7 @File Name
8 CommunicationServeur.h
9
10 @Auteurs
11 - Perret Mélissa
12
13 @Description
14 Fonctions liées à la communication entre l'ESP et le serveur
15 */
16 /* ************************************************************************** */ 17
18
19 #ifndef _COMMUNICATION_SERVEUR_H
20 #define _COMMUNICATION_SERVEUR_H
21
22 #define NOMBRE_TENTATIVES_REQUETES 10 // Combien de fois on essaye d'effectuer les requêtes HTTP (car des fois on obtient un read timeout sur le réseau de l'école)
23 #define HTTP_TIMEOUT_MS 10000 // Combien de fois on essaye d'effectuer les requêtes HTTP (car des fois on obtient un read timeout sur le réseau de l'école)
24 #define DELAI_NOUVELLE_TENTATIVE_HTTP_MS 2000 // Délai avant de réessayer une requête HTTP
25
26 // Tableau ASCII: https://ss64.com/ascii.html
27 const uint8_t OCTET_DEBUT = 0x02; // Caractère STX (Start of Text) utilisé pour identifier les débuts de trames
28 | const uint8_t OCTET_FIN = 0x03; // Caractère ETX (End of Text) utilisé pour
identifier les fins de trames
29
30 // Trame: OCTET_DEBUT + index + ':' + valeur + OCTET_FIN
31 const uint8_t TAILLE_TRAME = sizeof(OCTET_DEBUT) + sizeof(uint8_t) + sizeof(char) + sizeof(double) + sizeof(OCTET_FIN);
32
33 const char separateur = ':'; // Séparateur entre l'index et la valeur dans les trames, pour faciliter le debuggage
34
35 // Rappel format des trames :
36 // trame[0] = OCTET_DEBUT;
37 // trame[1] = index;
38 // trame[2] = ':';
39 // trame[3] à trame[10] = valeur;
40 // trame[11] = OCTET_FIN;
41 uint8_t trame[TAILLE_TRAME]; // Tableau pour envoyer les trames
42
43
44 // https://www.arduino.cc/reference/en/language/variables/data-types/array/
45 // Utilisation d'un tableau de String et d'un tableau de double séparés (au lieu d'utiliser un tableau de DefinitionValeur) car les valeurs String ne peuvent pas être sauvegardées dans la RTC
46 String nomValeursServeur[6]{
47 "seuilTemperatureMin",
48 "seuilTemperatureMax",
49 "ecartTemperature",
50 "seuilHumiditeMin",
51 "seuilHumiditeMax",
52 "ecartHumidite",
53 };
54
55 // Note : ne pas définir les valeurs initiales directement ici pour éviter de réinitialiser les valeurs à chaque réveil
56 | // les valeurs sont initialisées dans la fonction GestionReveil uniquement
lorsqu'on vient de démarrer l'ESP
57 RTC_DATA_ATTR double valeursServeur[6];
58
59
60 #endif /* _COMMUNICATION_SERVEUR_H */
