ETML-ES-SLO/PRJ_2409_Surveillance_T_H_Frigo/doc/Annexes/Annexes non triés/Annexe U/Annexe U1 _home.php.pdf

1 <!DOCTYPE html> <!-- Indispensable, indique qu'il s'agit d'une page HTML -->
2 <html lang=”fr”> <!-- Pas obligatoire, mais indique la langue du site -->
3 <head>
4 <meta charset="utf-8"> <!-- Encodage des caractères : accents, idéogrammes chinois et japonais, etc... --> 5 <title>Projet 2409 Mesure TH</title> <!-- Titre du site -->
6 </head>
7 <body>
8 <?php
9
10 // Important : ne pas oublier de Start MySQL dans dans XAMPP pour que ça fonctionne
11 $connexionSQL = mysqli_connect("localhost", "root", "", "mesureth"); // Connexion base de données
12
13 // Vérification connexion

### 14 if($connexionSQL === false) // Si la connexion a échouée

15 {
16 die("ERREUR: Connexion impossible. " . mysqli_connect_error()); 17 }
18
19 $requeteSQL = "SELECT * FROM valeurs";
20 $resultatRequeteSQL = mysqli_query($connexionSQL, $requeteSQL); 21

### 22 if($resultatRequeteSQL) // Si requête effectuée avec succès

23 {
24 $colonnes = $resultatRequeteSQL->fetch_assoc(); // Récupérer les résultats 25 }

### 26 else

27 {
28 echo "ERREUR: Impossible d'executer la requete SQL suivante: $sql. " . mysqli_error($connexionSQL); 29 }
30

### 31 mysqli_close($connexionSQL); // Fermer la connexion

32
33 ?>
34
35 <!-- Formulaire -->
36 <!-- valeurs initiales provenant de la base de données en utilisant le php --> 37 <form method="post" action="form.php"> <!-- Execution de form.php lorsque le formulaire est envoyé avec le bouton Envoyer --> 38 <h1>Page pour le réglages des seuils et écarts pour le projet 2409 </h1> <!-- H1 pour titre -->
39
40 <!-- step pour définir le la précision des valeurs -->
41 <label>Seuil température min :</label>
42 <input type="number" step="0.01" name="SeuilTemperatureMin" id= "SeuilTemperatureMin" value="<?php echo $colonnes["seuilTemperatureMin"]; ?>"> [°C]<br>
43
44 <label>Seuil température max :</label>
45 <input type="number" step="0.01" name="SeuilTemperatureMax" id= "SeuilTemperatureMax" value="<?php echo $colonnes["seuilTemperatureMax"]; ?>"> [°C]<br>
46 <br>
47
48 <label for="EcartTempMax">Ecart température :</label>
49 <input type="number" step="0.01" min="0" name="EcartTemperature" id= "EcartTemperature" value="<?php echo $colonnes["ecartTemperature"]; ?>"> [°C]<br>
50 <br>
51
52 <label>Seuil humidité min :</label>
53 <input type="number" min="0" max="100" name="SeuilHumiditeMin" id= "SeuilHumiditeMin" value="<?php echo $colonnes["seuilHumiditeMin"]; ?>"> [%]<br>
54
55 <label>Seuil humidité max :</label>
56 <input type="number" min="0" max="100" name="SeuilHumiditeMax" id= "SeuilHumiditeMax" value="<?php echo $colonnes["seuilHumiditeMax"]; ?>"> [%]<br>

57 <br>
58
59 <label>Ecart humidité :</label>
60 <input type="number" min="0" max="100" name="EcartHumidite" id= "EcartHumidite" value="<?php echo $colonnes["ecartHumidite"]; ?>"> [%]<br>

61 <br>
62
63 <input type="submit" value="Envoyer"> <!-- Bouton pour envoyer le formulaire -->
64 </form>
65
66
67 <br><br>
68
69 <?php
70 // Si l'alarme vaut vrai dans la base de données (valeur transmise par le STM à l'ESP, puis par l'ESP à la base de données)

### 71 if($colonnes["alarme"] == true)

72 {

### 73 echo "<div style='color:red; text-align: center; font-size:200px'>Alarme

!</div>"; // Afficher un message d'alerte sur la page 74 }
75
76 // Si pilesFaibles vaut vrai dans la base de données (valeur transmise par le STM à l'ESP, puis par l'ESP à la base de données)

### 77 if($colonnes["pilesFaibles"] == true)

78 {

### 79 echo "<div style='color:red; text-align: center; font-size:200px'>Piles

faibles !</div>"; // Afficher un message d'alerte sur la page 80 }
81
82 ?>
83 </body>
84
85 </html>
