ETML-ES-SLO/PRJ_2409_Surveillance_T_H_Frigo/doc/Annexes/Annexes non triés/Annexe U/Annexe U3 _api.php.pdf

1 <?php
2
3 // Fichier php utilisé pour traiter les requêtes HTTP depuis l'ESP (recevoir/modifier les données de la base de données) 4
5
6 header("Content-Type: application/json"); // Indique que le traitement s'ffectue en JSON
7
8 // Important : ne pas oublier de Start MySQL dans dans XAMPP pour que ça fonctionne
9 $connexionSQL = mysqli_connect("localhost", "root", "", "mesureth"); // Connexion à la base de données
10
11 // Vérification connexion
12 if($connexionSQL === false) // Si la connexion a échouée
13 {
14 die("ERREUR: Connexion impossible. " . mysqli_connect_error()); 15 }
16
17 $typeDeRequete = $_SERVER['REQUEST_METHOD'];
18
19 switch ($typeDeRequete) {
20 case 'GET':
21 TraiterRequeteGet($connexionSQL); 22 break;
23 case 'PUT':
24 TraiterRequetePut($connexionSQL);
25 break;
26 default:
27 echo json_encode(['message' => 'Type de requete invalide']); 28 break;
29 }
30
31 mysqli_close($connexionSQL); // Fermer la connexion
32
33
34 //// Fonction TraiterRequeteGet (traitement des requêtes HTTP de type GET) 35 //// Description:
36 //// Entrées: connexionSQL
37 //// Sorties: -
38 function TraiterRequeteGet($connexionSQL)
39 {
40 // Requête SQL pour récupérer les données de la base de données 41 $requeteSQL = "SELECT
seuilTemperatureMin,seuilTemperatureMax,ecartTemperature,seuilHumiditeMin,seui lHumiditeMax,ecartHumidite FROM valeurs";
42
43 $resultatRequeteSQL = mysqli_query($connexionSQL, $requeteSQL); // Exécution de la requête
44 if($resultatRequeteSQL) // Si requête exécutée avec succès
45 {
46 $colonnes = $resultatRequeteSQL->fetch_assoc(); // Récupèrer les résultats de la requête

### 47 echo json_encode($colonnes); // Encoder les résultats en JSON avec

json_encode et transmettre la réponse avec echo 48 }
49 else // Echec lors de l'exécution de la requête
50 {
51 echo "ERREUR: Impossible d'exécuter la requête SQL: $requeteSQL. " . mysqli_error($connexionSQL); 52 }
53 }
54
55 //// Fonction TraiterRequetePut (traitement des requêtes HTTP de type PUT) 56 //// Description:
57 //// Entrées: connexionSQL
58 //// Sorties: -
59 function TraiterRequetePut($connexionSQL)
60 {
61 parse_str(file_get_contents("php://input"), $putData); // Récupérer les données passées dans la requête et les stocker dans la variable $putData

62

### 63 if(count($putData) == 0) // Si la requête HTTP ne contient aucune données

64 {
65 // Pas de paramètres à modifier
66 echo "Pas de param";
67 return;
68 }
69
70 // Construction de la requête SQL
71 $requeteSQL = "UPDATE valeurs SET";
72
73 // Ajout des paramètres (nom et nouvelle valeur) indiqués dans la requête PUT reçue

### 74 foreach ($putData as $nom => $valeur)

75 {
76 // On ajoute chaque données reçues (nom/valeur) à la requête SQL
77 $requeteSQL .= " $nom='$valeur',"; // .= pour ajouter à la suite du text existant (+= ne marche pas) 78 }
79
80 $requeteSQL = trim($requeteSQL, ','); // Pour enlever la virgule en trop à la fin
81
82
83 //echo $requeteSQL; // Pour debugguer la requête SQL créée 84 //return;
85
86 // Exécution de la requête

### 87 if(mysqli_query($connexionSQL, $requeteSQL)) // Si requête exécutée avec sucès

88 {
89 echo "OK!";
90 }

### 91 else // Echec lors de l'exécution de la requête

92 {
93 echo "ERREUR: Impossible d'exécuter la requête SQL: $requeteSQL. " . mysqli_error($connexionSQL); 94 }
95 }
96 ?>
