ETML-ES-SLO/PRJ_2409_Surveillance_T_H_Frigo/doc/Capture oscillo/Tension alimentation.png

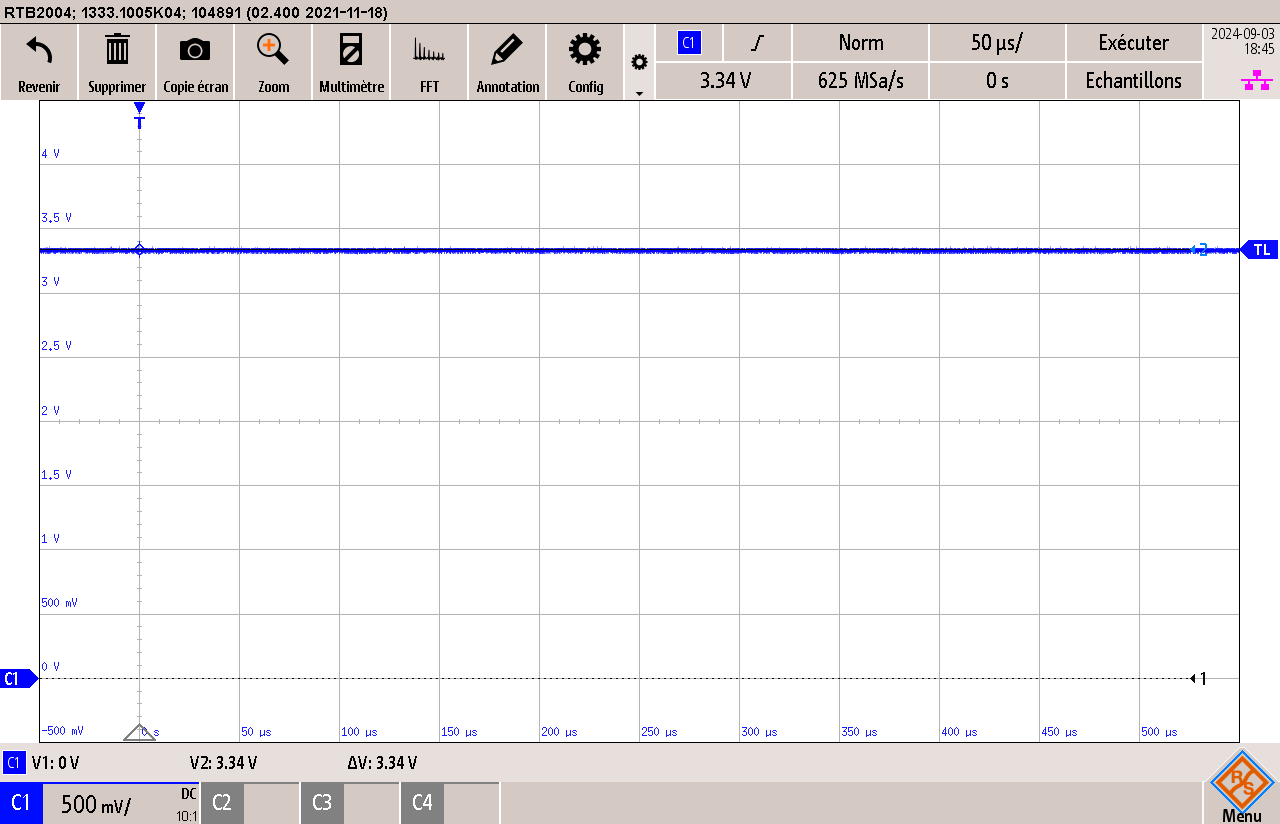
doc/Capture oscillo/Tension alimentation.png
