ETML-ES-SLO/PRJ_2409_Surveillance_T_H_Frigo/mec/Espacement pour le boitier.PNG

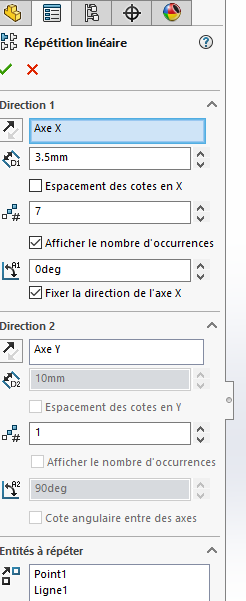
mec/Espacement pour le boitier.PNG
