ETML-ES-SLO/PRJ_2409_Surveillance_T_H_Frigo/doc/Estimation  durée de vie et prix .xlsx

Délai entre deux réveils [minutes] | Total heures mensuelles [heures / mois] | Durée réveil microcontrôleurs [secondes] | Rafraichissements e-paper [nombre / mois] |  | Durée rafraichissement e-paper [secondes] | Composants | Quantité | Numéro de référence | Prix unitaire (par composant) [CHF] | Total (par composant) [CHF]
60 | 720 | 10 | 100 |  | 6 | PCB | 1 | - | 30 | 30
 |  |  |  |  |  | Microcontrôleur | 1 | STM32F072C8T6TR | 4.26 | 4.26
 |  |  |  |  |  | E-paper | 1 | 24963573 | 16.9 | 16.9
Composants | Consommation en mode sommeil [mA] | Consommation en mode réveil [mA] | Sommeil / mois [heures] | Réveil / mois [heures] | Consommation moyenne [mA] | ESP32 | 1 | ESP32-C3-WROOM-02-N4 | 1.69 | 1.69
STM32 | 0.90 | 4.75 | 718 | 2 | 0.911 | Composants divers | 30 | - | 1.2 | 36
ESP32 | 0.005 | 82 | 718 | 2 | 0.233
E-paper | 0.02 | 3.50 | 719.833 | 0.167 | 0.021
Autres | 0.50 | 0.50 | 718 | 2 | 0.500 | Prix total |  |  | 54.05 | 88.85
Total | 1.425 | 90.75 |  |  | 1.664
 |  | Alimentation | Capacité [mAh] |  | Autonomie [jours]
 |  | Supercondensateur | 667.5 |  | 16.71
 |  | Piles AAA | 1200 |  | 30.04
