ETML-ES-SLO/PRJ_2409_Surveillance_T_H_Frigo/doc/Estimation des prix.xlsx

Composants | Quantité | Numéro de référence | Prix unitaire (par composant) [CHF] | Total (par composant) [CHF]
PCB | 1 | - | 40 | 40
Microcontrôleur | 1 | STM32F072C8T6TR | 4.26 | 4.26
E-paper | 1 | 24963573 | 16.9 | 16.9
ESP32 | 1 | ESP32-C3-WROOM-02-N4 | 1.69 | 1.69
Sparkfun-16467 | 1 | SEN-16467 | 9.53 | 9.53
Composants divers | 30 | - | 1.2 | 36
Prix total |  |  | 73.58 | 108.38
 |  | Coût estimé [CHF] | Coût réel [CHF]
 |  | 108.38 | 94.78
