ETML-ES-SLO/PRJ_2409_Surveillance_T_H_Frigo/mec/2409_Base_CapteurTemperature_V1.SLDPRT

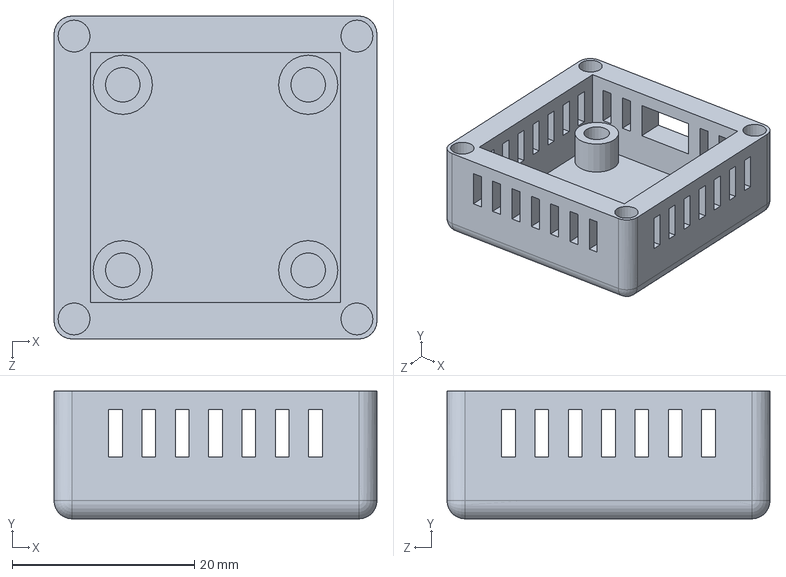
[picture p116: CAD file, 2024-09-24]
mec/2409_Base_CapteurTemperature_V1.SLDPRT
35.4 x 14.0 x 35.4 mm
