ETML-ES-SLO/PRJ_2409_Surveillance_T_H_Frigo/mec/2409_BoitierPCB_Base_V1.SLDPRT

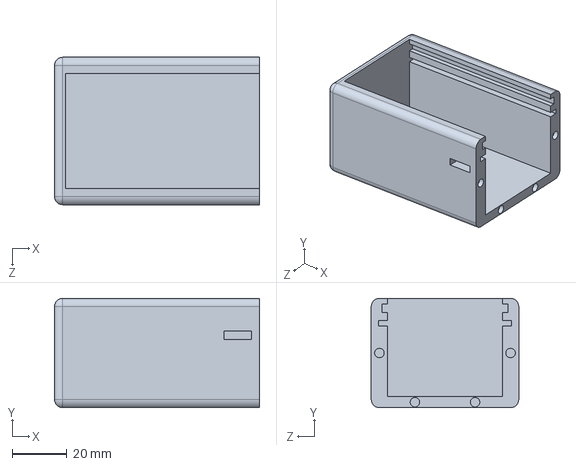
[picture p117: CAD file, 2024-09-24]
mec/2409_BoitierPCB_Base_V1.SLDPRT
75.0 x 40.0 x 54.0 mm
