ETML-ES-SLO/PRJ_2409_Surveillance_T_H_Frigo/mec/2409_Couvercle_BoitierPCB_V1.SLDPRT

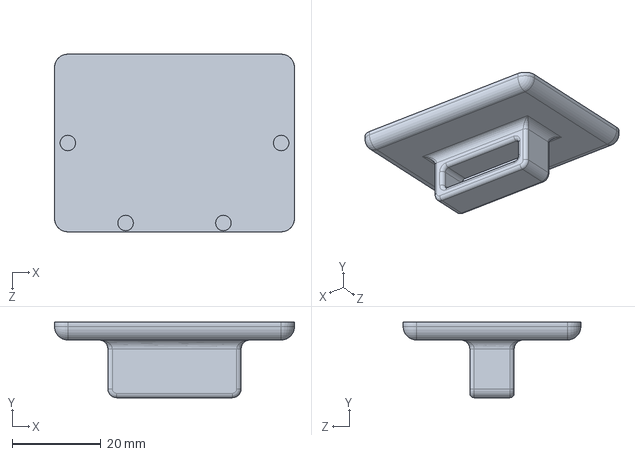
[picture p119: CAD file, 2024-09-24]
mec/2409_Couvercle_BoitierPCB_V1.SLDPRT
54.0 x 17.0 x 40.0 mm
