ETML-ES-SLO/PRJ_2409_Surveillance_T_H_Frigo/mec/Support pile.SLDPRT

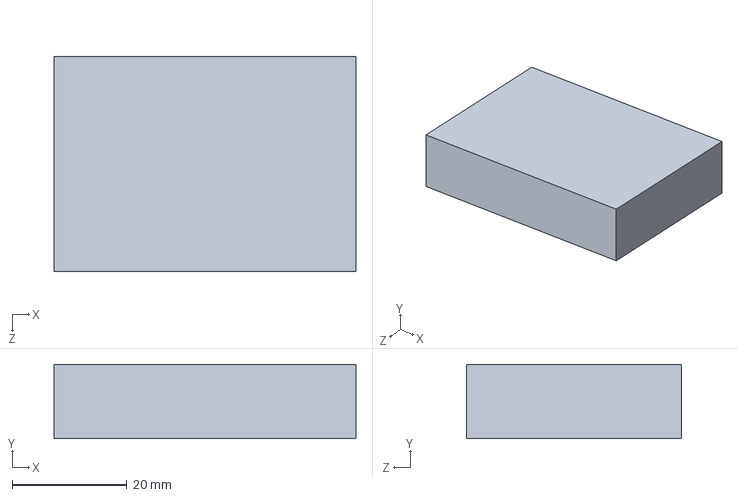
[picture p120: CAD file, 2024-09-24]
mec/Support pile.SLDPRT
52.7 x 13.0 x 37.5 mm
