ETML-ES-SLO/PRJ_2409_Surveillance_T_H_Frigo/mec/Assemblageboitier SparkFun.SLDASM

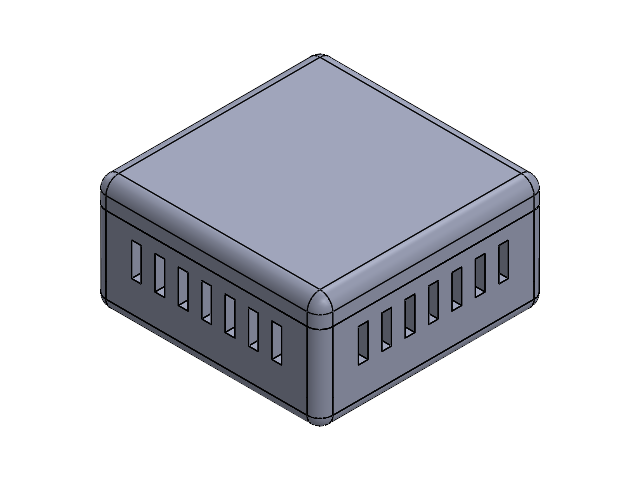
[picture p121: CAD file, 2024-09-24]
mec/Assemblageboitier SparkFun.SLDASM
Boitier_capteur_temperature
Boitier_capteur_temperature_Fermeture
