ETML-ES-SLO/PRJ_2409_Surveillance_T_H_Frigo/(list of files, cad)

Other CAD files:
mec/2409_BoitierPCB_CASE_V1.SLDDRW
mec/2409_Case_CapteurTemperature_V1.SLDDRW
mec/2409_Couvercle_BoitierPCB_V1.SLDDRW
mec/2409_Couvercle_CapteurTemperature_V1.SLDDRW
