ETML-ES-SLO/PRJ_2409_Surveillance_T_H_Frigo/doc/Annexes/Annexes non triés/Annexe H_SparkFun_Qwiic_Humidity_Temperature_SHTC3_Schematic.pdf

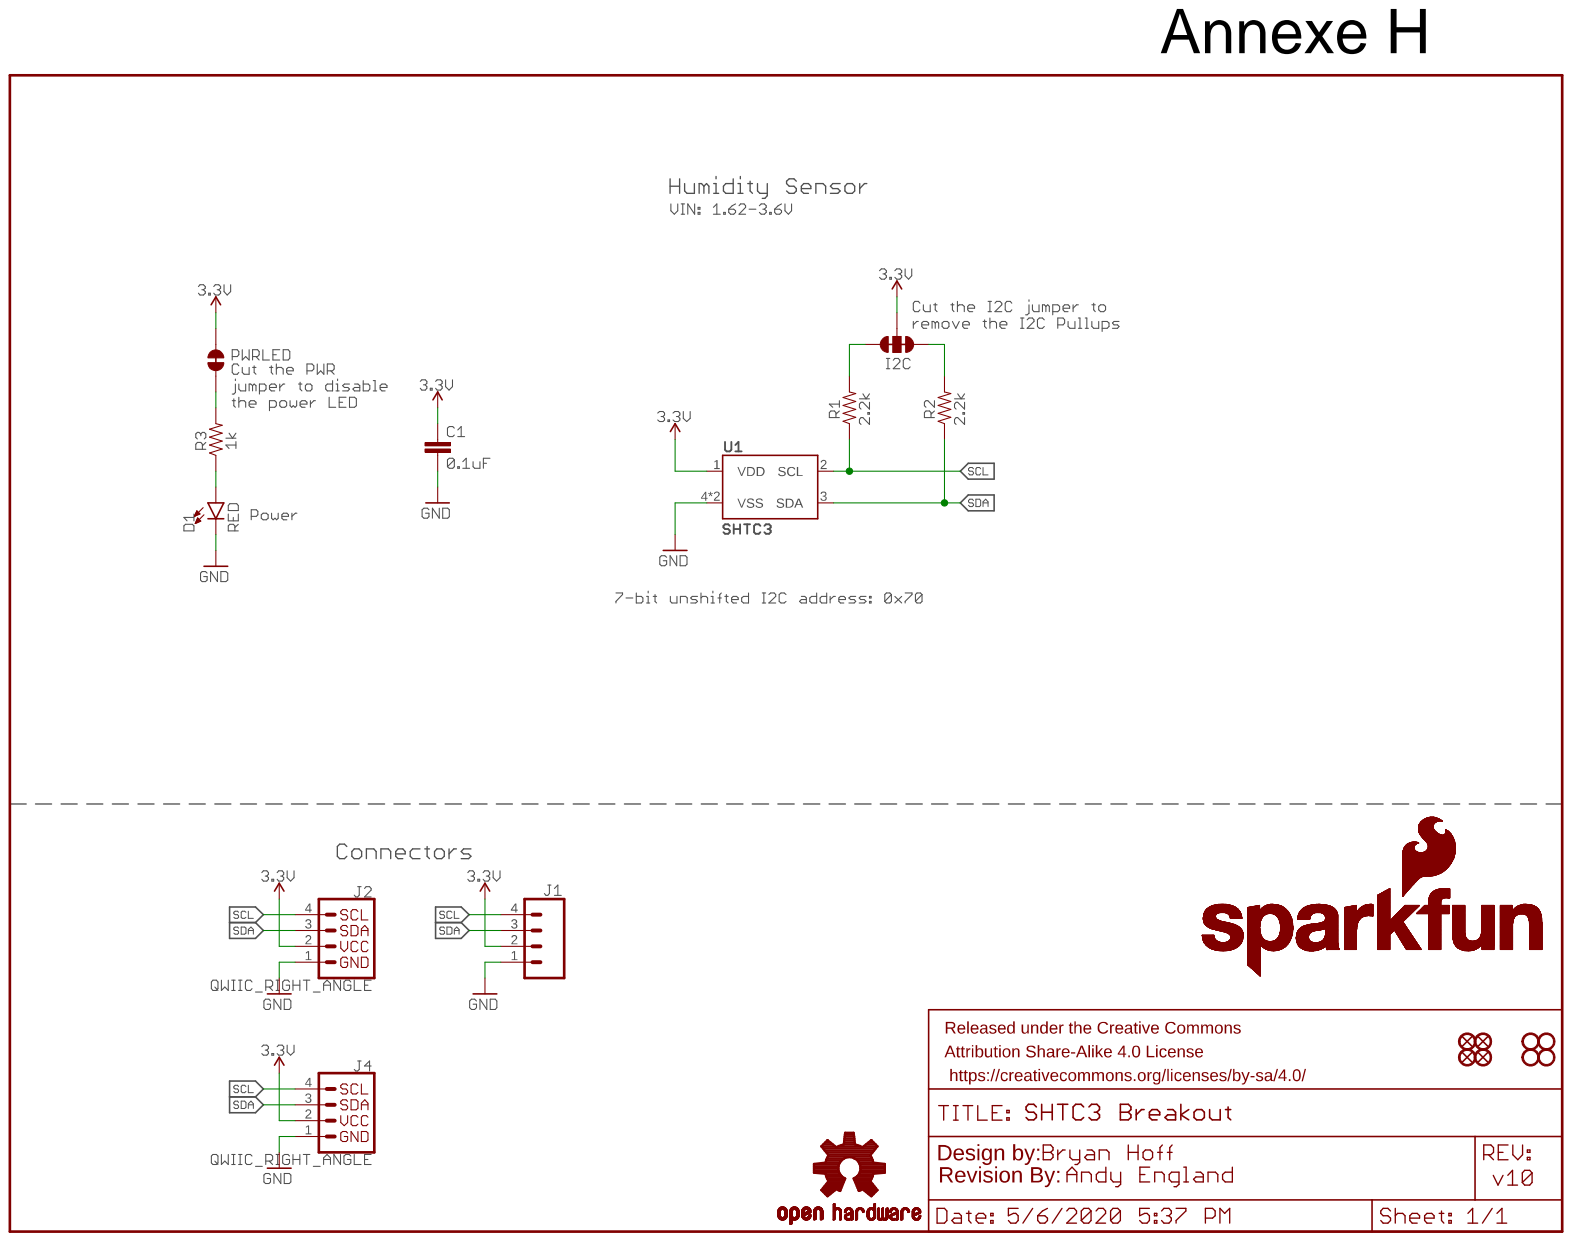
[picture p122: page 1]
