ETML-ES-SLO/PRJ_2409_Surveillance_T_H_Frigo/hard/2409_MesureTH_RefrigerateurCongelateur_V1/Project Outputs for 2409_MesureTH_V1/DesignDocs/2409_M_TH_R_V1__Draftsman.PDF

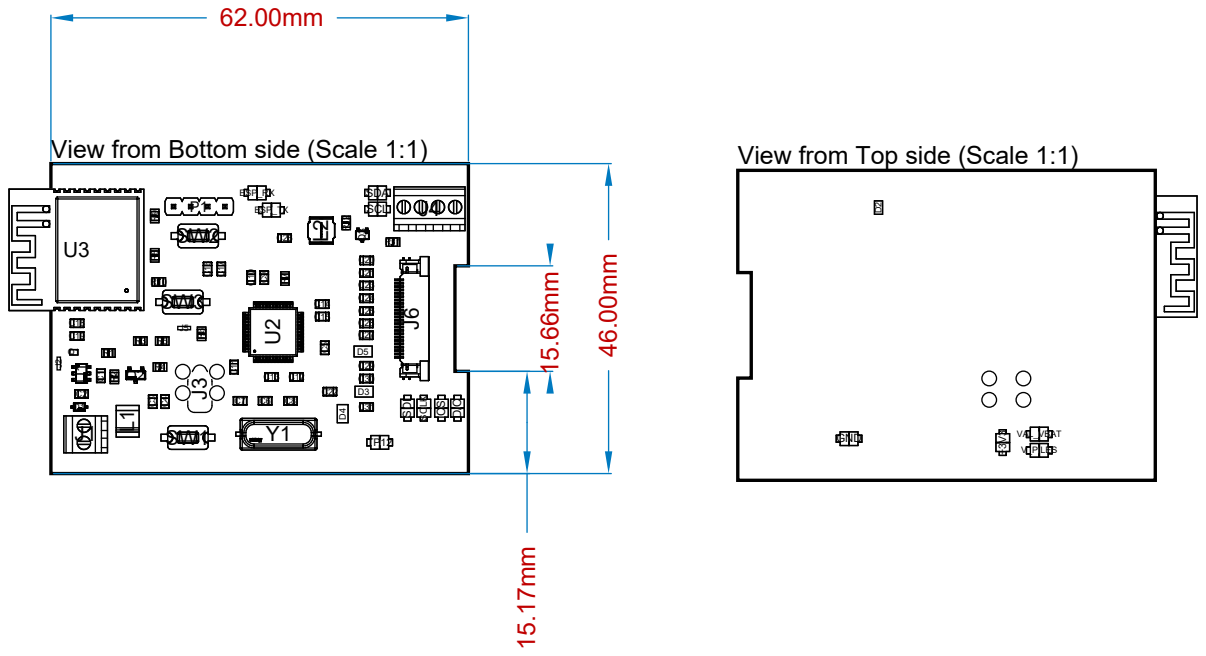
[picture p123: page 1]

View from Bottom side (Scale 1:1)

View from Top side (Scale 1:1)

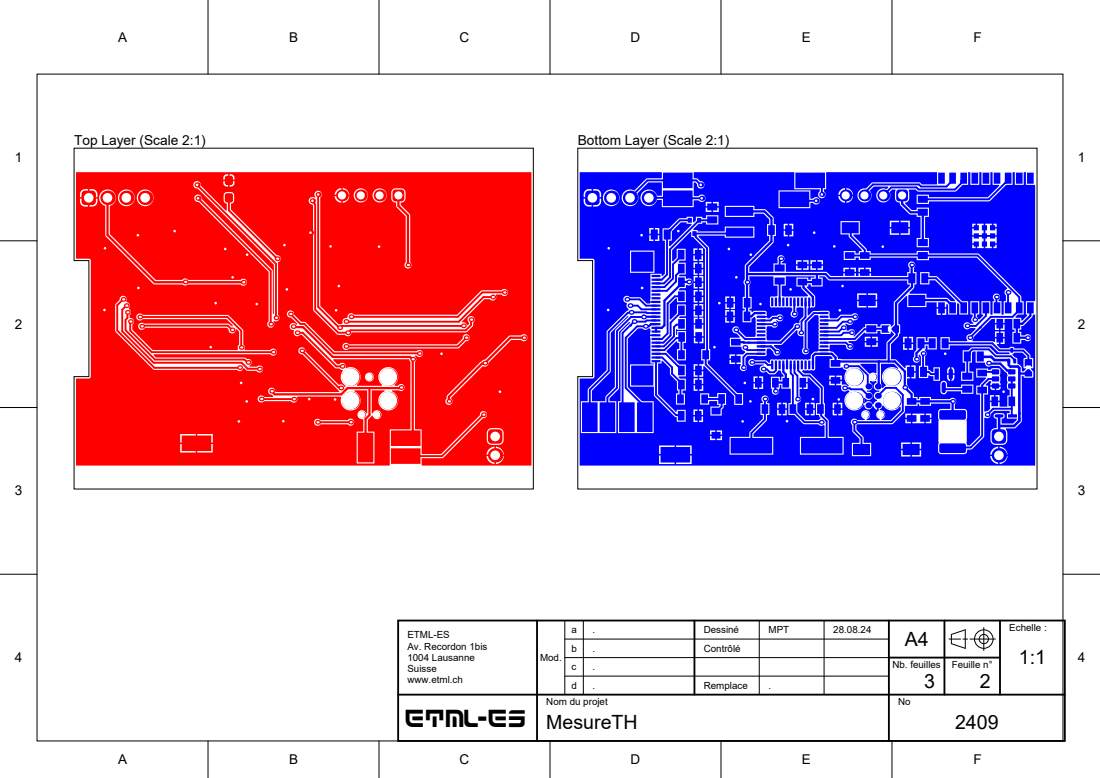
[picture p124: page 2]

ETML-ES Av. Recordon 1bis 1004 Lausanne Suisse www.etml.ch | Mod. | a | . | Dessiné | MPT | 28.08.24 | A4 | | Echelle : 1:1

b | . | Contrôlé
c | . | | | | Nb. feuilles 3 | Feuille n° 2
d | . | Remplace | .
Nom du projet | | | | | | No

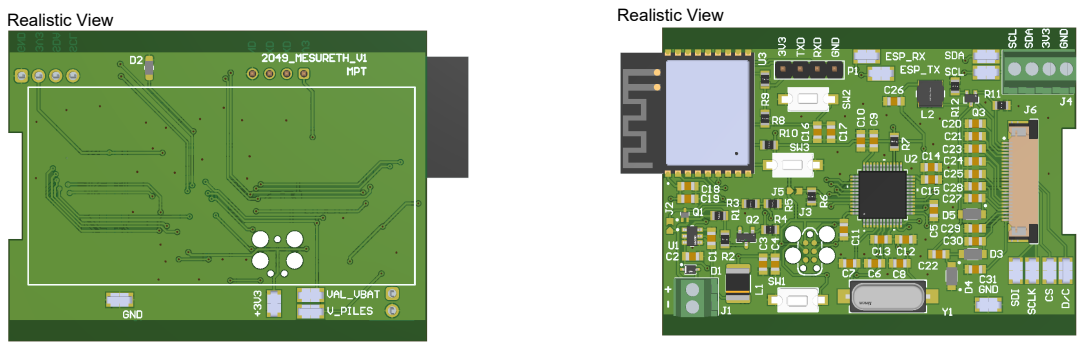
[picture p125: page 3]
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

b | . | Contrôlé
c | . | | | | Nb. feuilles 3 | Feuille n° 3
d | . | Remplace | .
Nom du projet | | | | | | No
