ETML-ES-SLO/PRJ_2409_Surveillance_T_H_Frigo/hard/2409_MesureTH_RefrigerateurCongelateur_V1/Project Outputs for 2409_MesureTH_V1/DesignDocs/2409_M_TH_R_V1_ASY.PDF

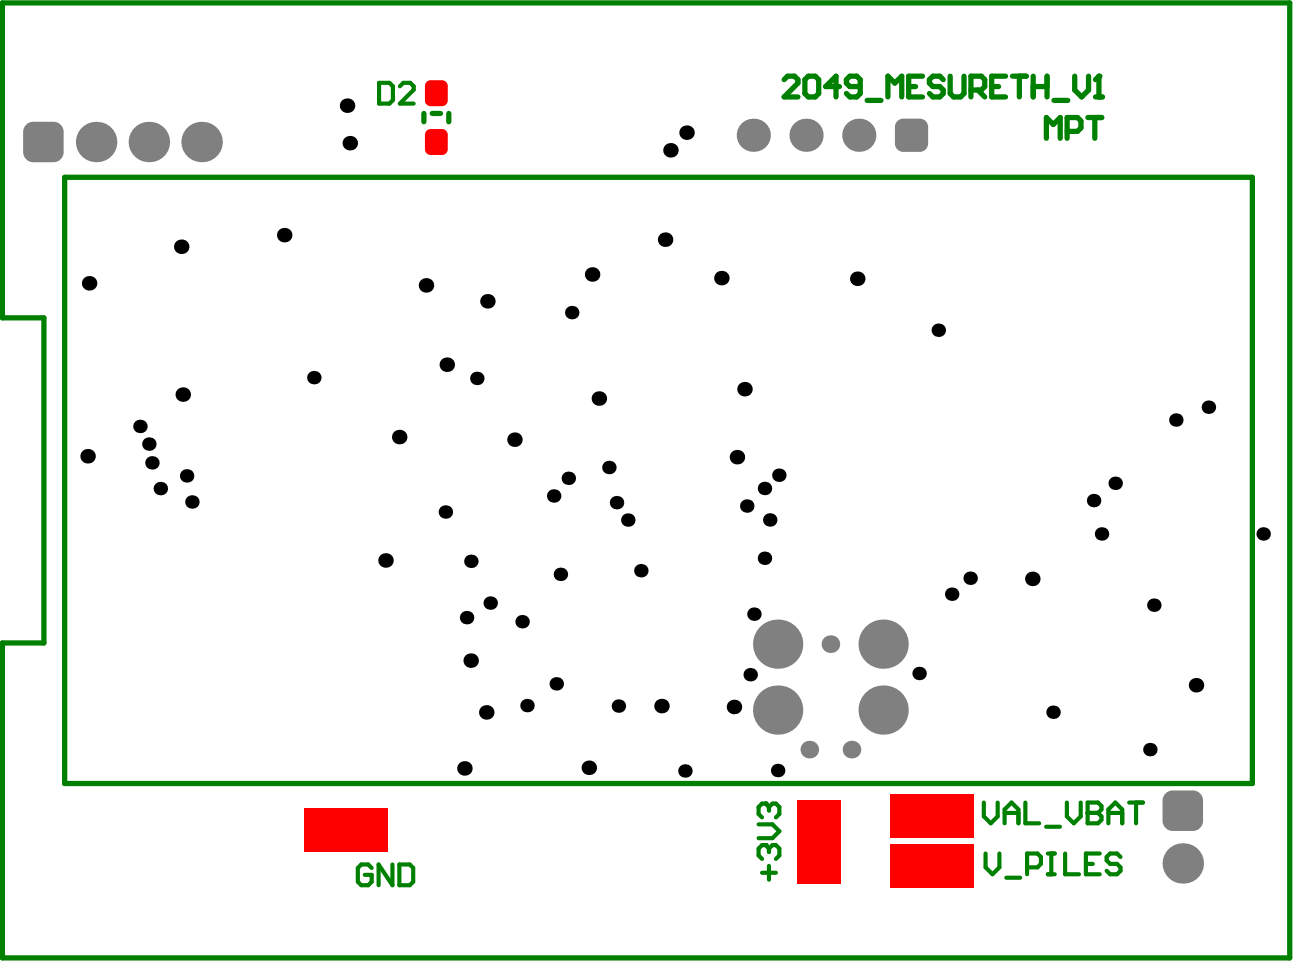
[picture p126: page 1]

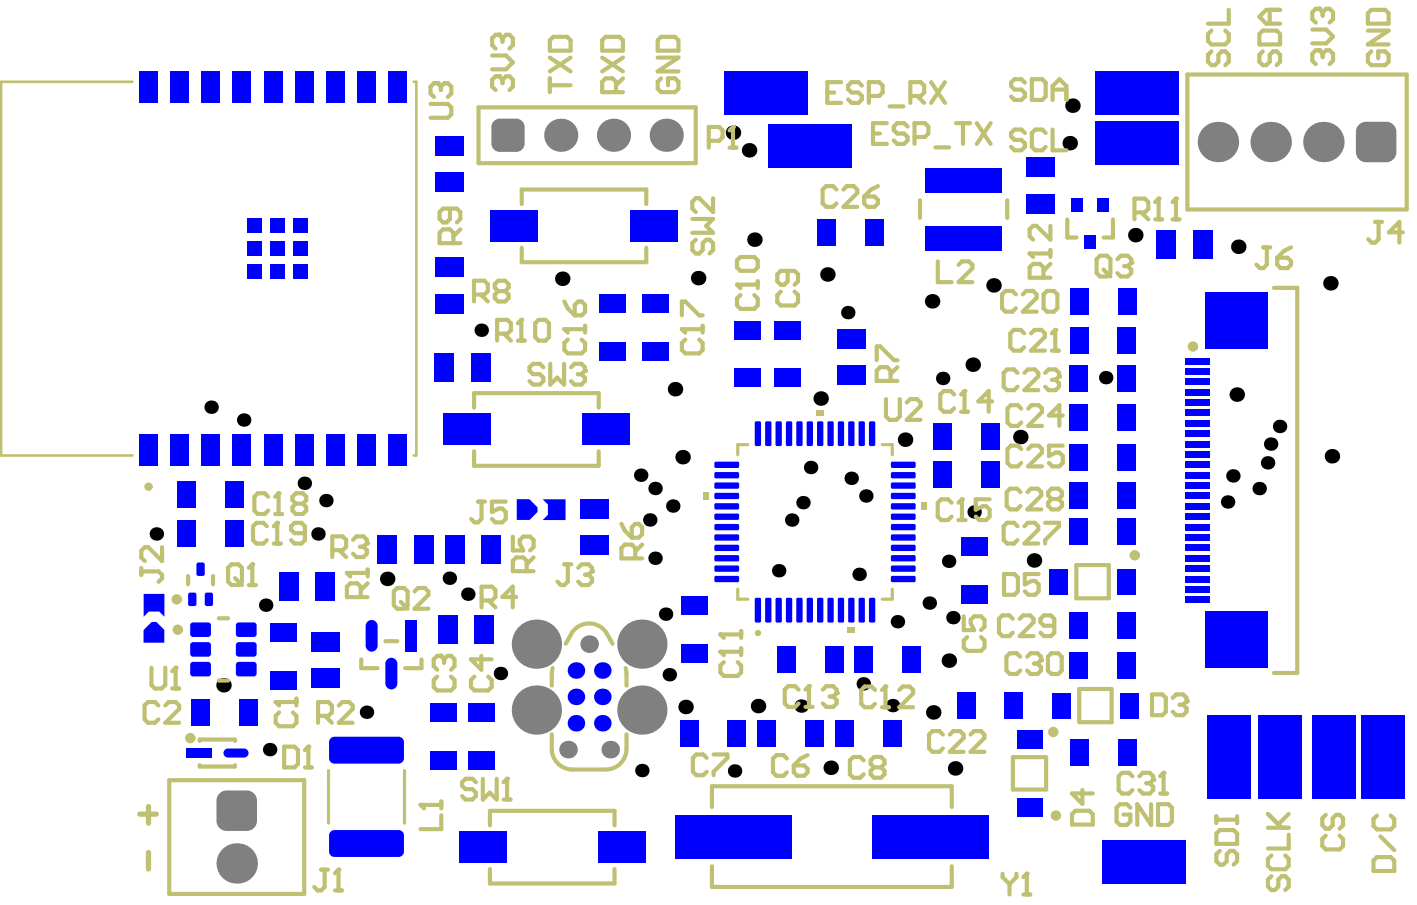
[picture p127: page 2]
