ETML-ES-SLO/PRJ_2409_Surveillance_T_H_Frigo/hard/2409_MesureTH_RefrigerateurCongelateur_V1/Project Outputs for 2409_MesureTH_V1/DesignDocs/2409_M_TH_R_V1_Schématic.PDF

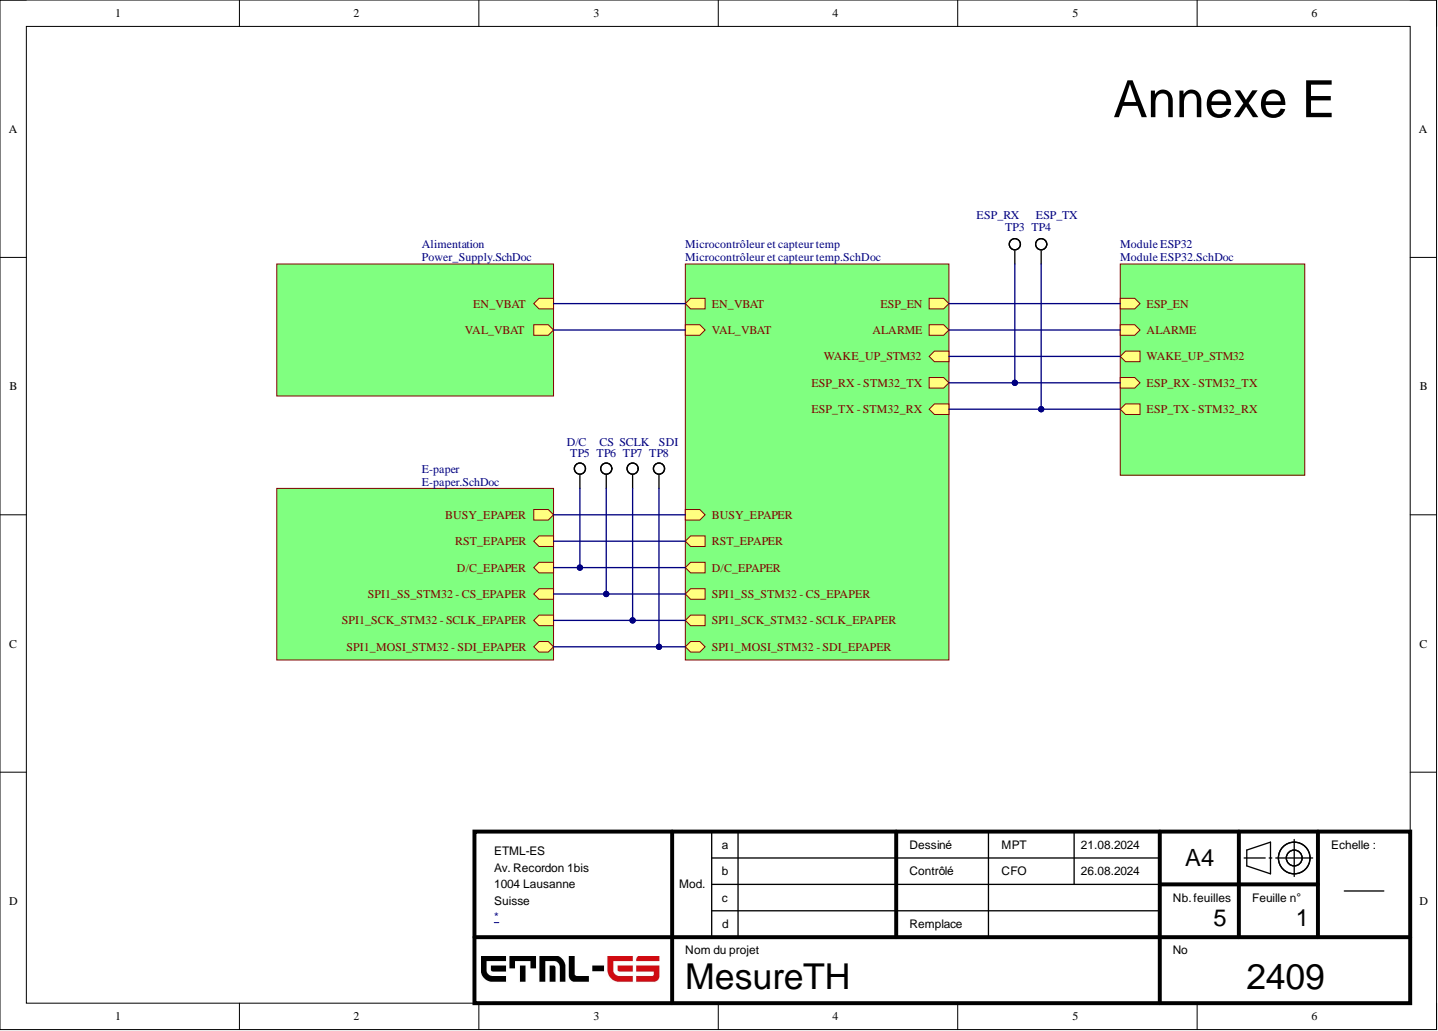
[picture p128: page 1]

Microcontrôleur et capteur temp
Microcontrôleur et capteur temp.SchDoc

ETML-ES Av. Recordon 1bis 1004 Lausanne Suisse * | Mod. | a | Dessiné | MPT | 21.08.2024 | A4 | | Echelle :

b | Contrôlé | CFO | 26.08.2024

c | | | | Nb. feuilles 5 | Feuille n° 1

d | Remplace

Nom du projet MesureTH | | | | | No 2409

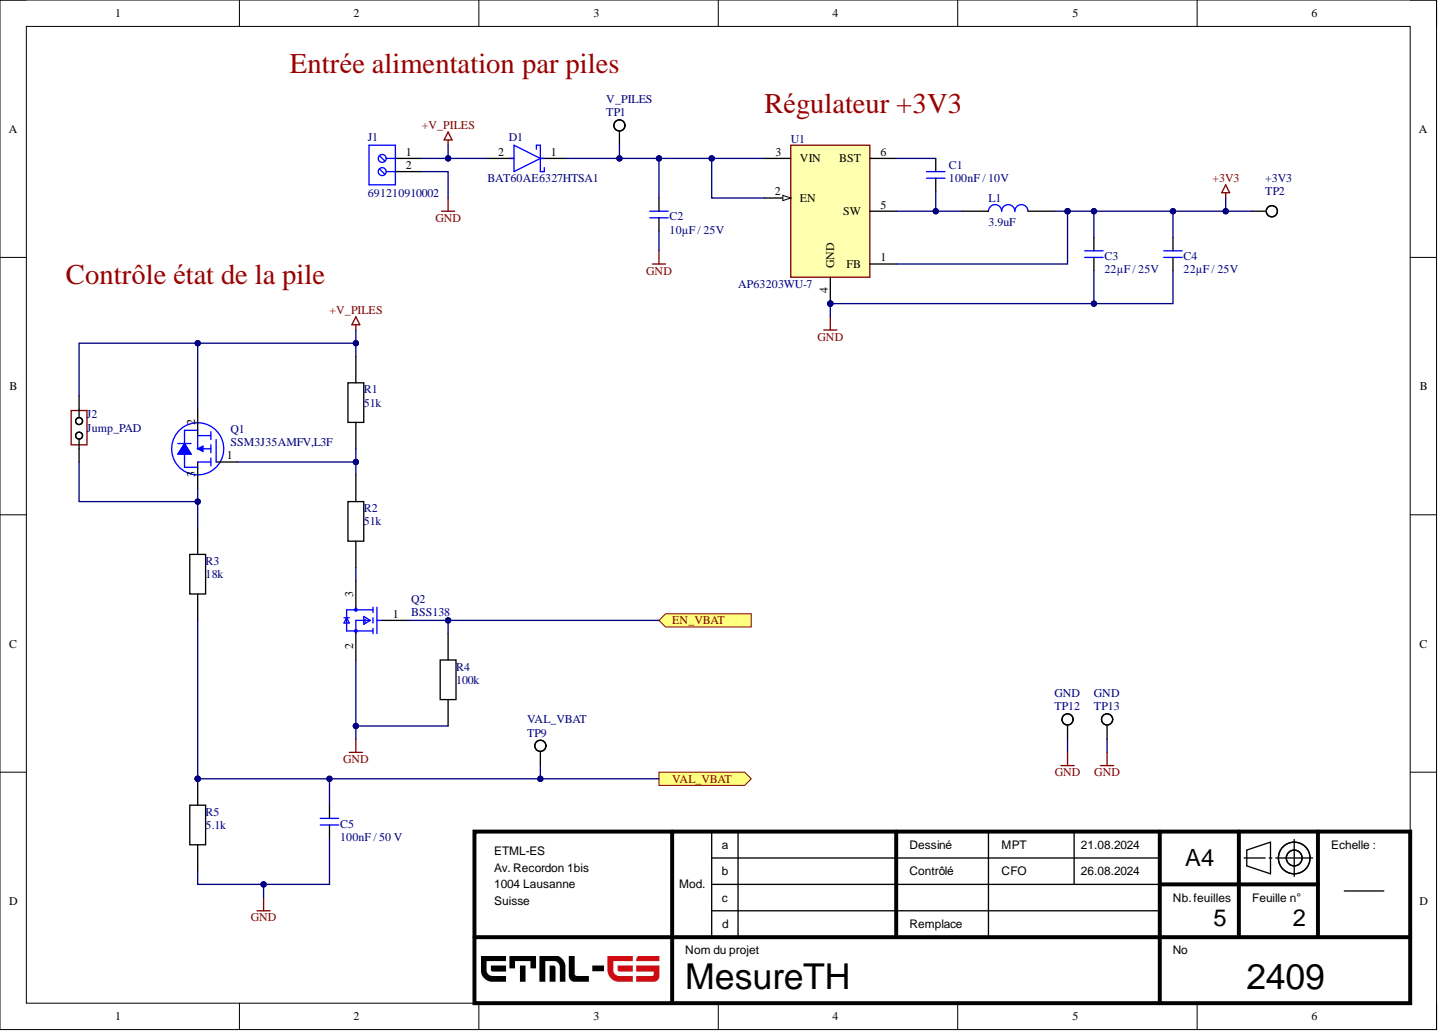
[picture p129: page 2]

ée alimentation par piles

état de la pile

ET ML-E S Av . Recordon 1bis 1004 Lausanne Suis s e | Mod . | | Des s i n é | MPT CFO | 26.08.20 21.08.20 2 4 | A4 | | Echelle :

abcd | Cont r ô l é | | 2 4

Nb. feuilles 5 | Feuille n ° 2

Rempla c e

Nom du projet Mesu r eTH | | N o 240

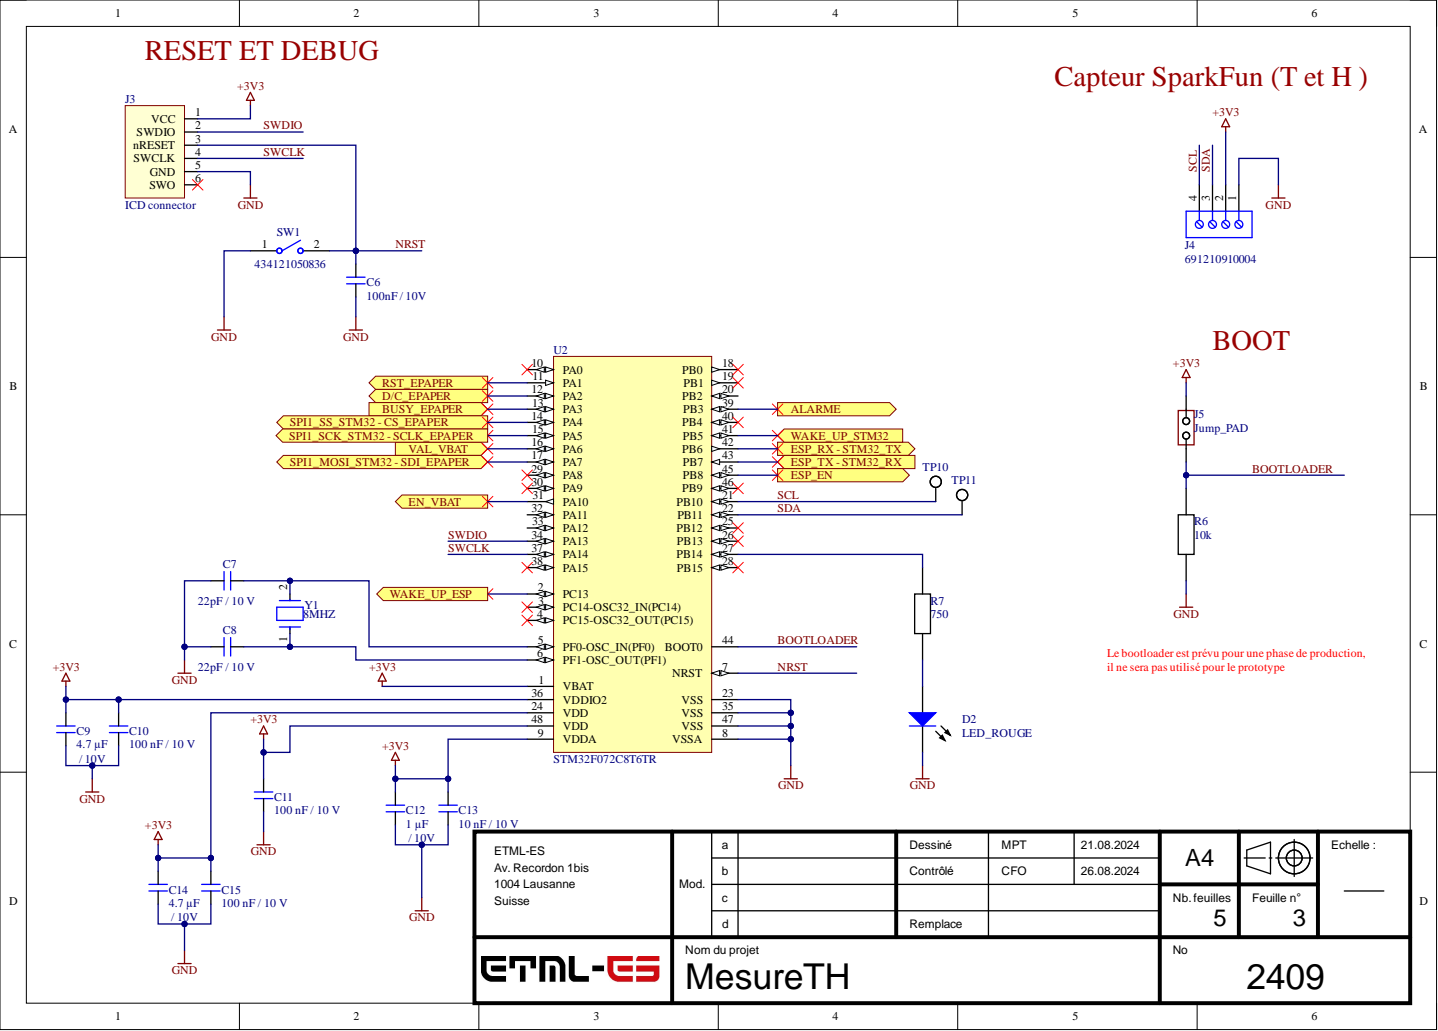
[picture p130: page 3]

3 6
2 4 | 3 5

ET ML-E Recordon 1bis 1004 Lausanne | Mod . | | | Des s i n é | MPT CFO | 26.08.20 21.08.20 2 4 | | Echelle :
Av . Suis s e | | abcd | | Cont r ô l é | 2 4

Nb. feuilles 5 | Feuille n ° 3

Rempla c e

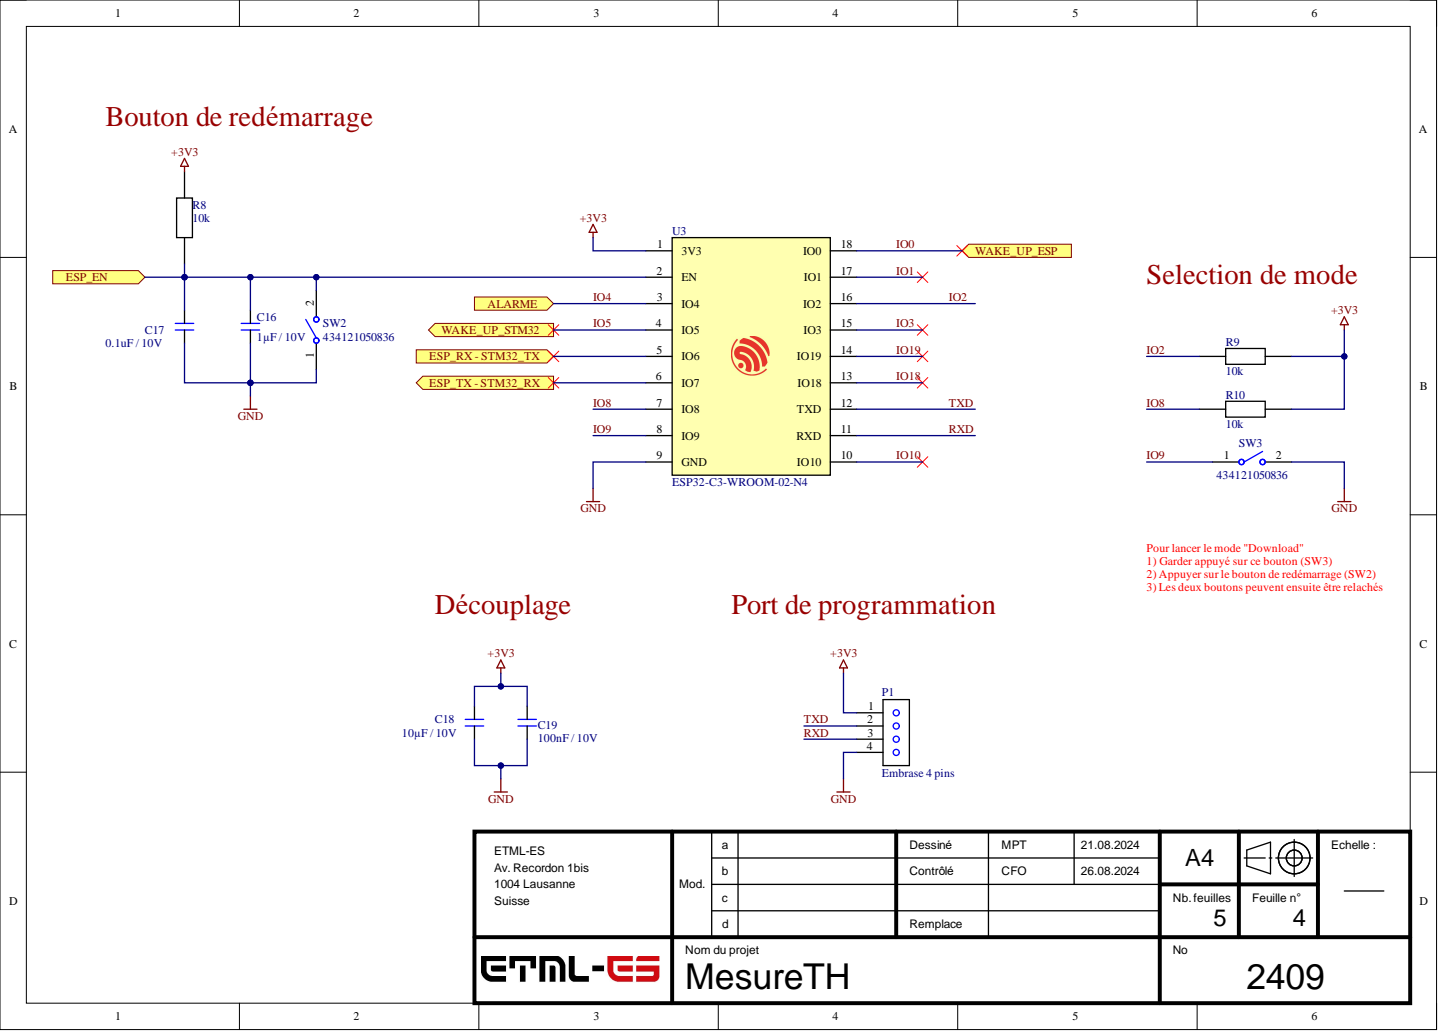
[picture p131: page 4]

Pour lancer le mode "Download"
1) Garder appuyé sur ce bouton (SW3)
2) Appuyer sur le bouton de redémarrage (SW2)
3) Les deux boutons peuvent ensuite être relachés

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

b | Contrôlé | CFO | 26.08.2024

c | | | | Nb. feuilles 5 | Feuille n° 4

d | Remplace

Nom du projet MesureTH | | | | | No 2409

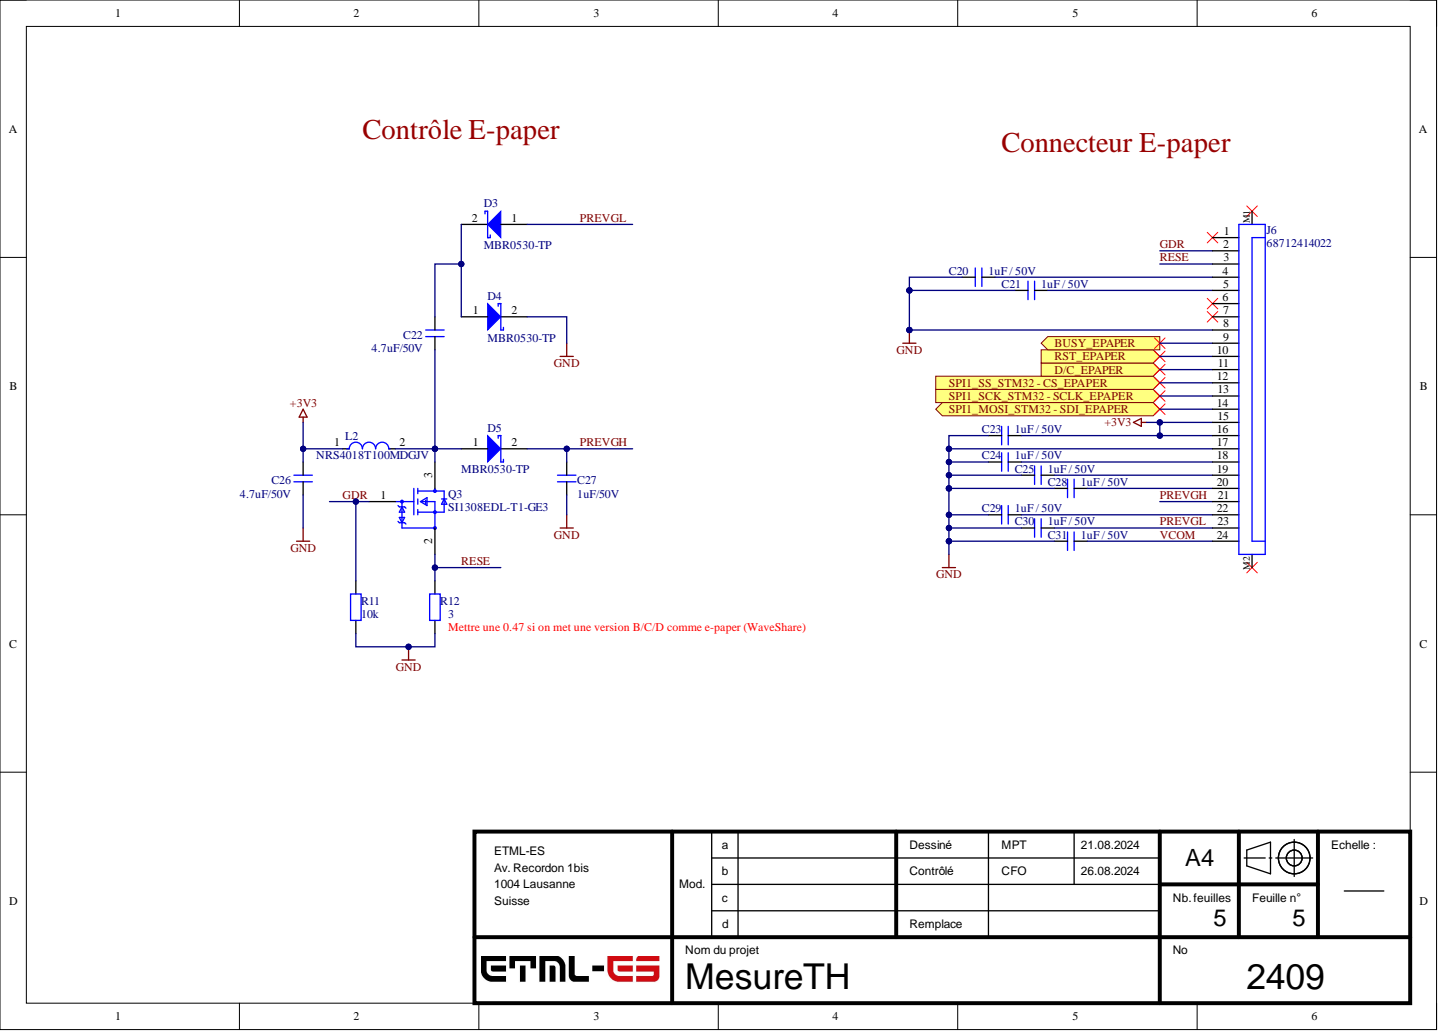
[picture p132: page 5]

C2 5 | 1 uF / 5 0 V 1 9
C2 8 | 1 uF / 5 0 V 2

C3 0 | 1 uF / 5 0 V PRE V G L
C3 1 | 1 uF / 5 0 V VCO M

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

abcd | Cont r ô l é | | 2 4

Nb. feuilles 5 | Feuille n ° 5

Rempla c e
