ETML-ES-SLO/PRJ_2409_Surveillance_T_H_Frigo/mec/2409_BoitierPCB_CASE_V1.pdf

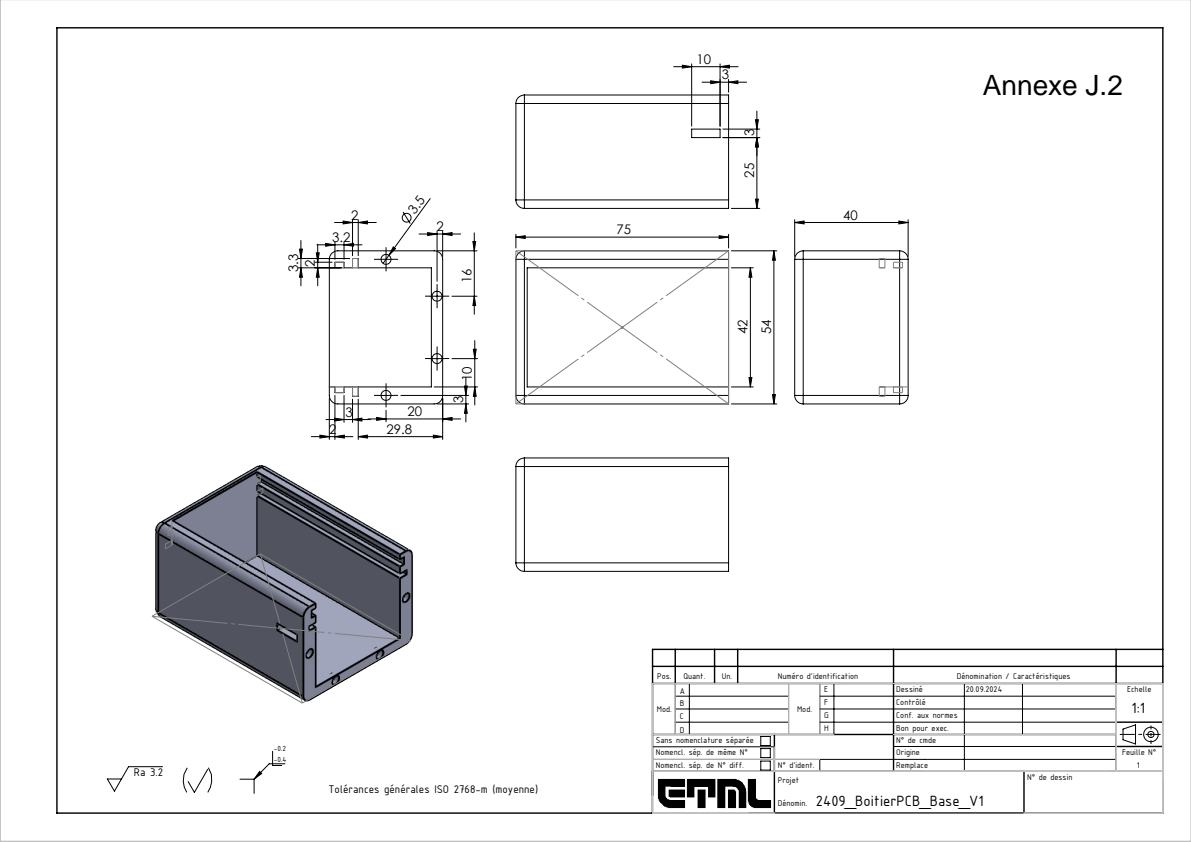
[picture p133: page 1]
Feuille N°

Pos. | Quant. | Un. | Numéro d'identification | Dénomination / Caractéristiques
Mod. | A B C D | Mod. | E F G H | Dessiné 20.09.2024 Contrôlé Conf. aux normes Bon pour exec. | Echelle 1:1

N° de cmde Origine Remplace

Sans nomenclature séparée
Nomencl. sép. de même N°

Nomencl. sép. de N° diff. | | N° d'ident.

2409_BoitierPCB_Base_V1 Dénomin. | N° de dessin Projet

Tolérances générales ISO 2768-m (moyenne)
