ETML-ES-SLO/PRJ_2409_Surveillance_T_H_Frigo/doc/Annexes/Annexes non triés/Annexe F.1_2409_MesureTH_RefrigerateurCongelateur_V1_ASY.PDF

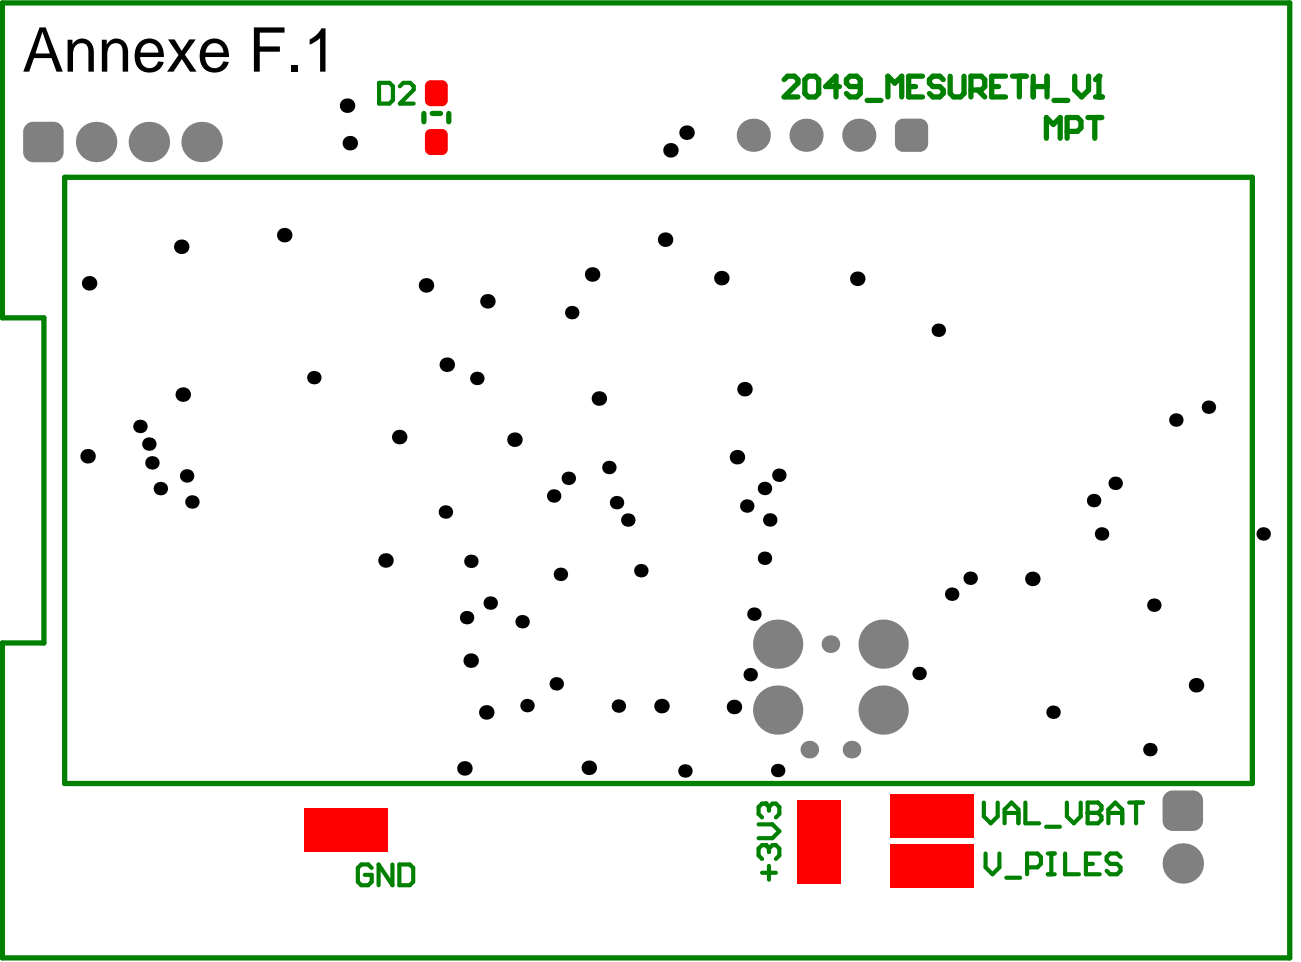
[picture p134: page 1]

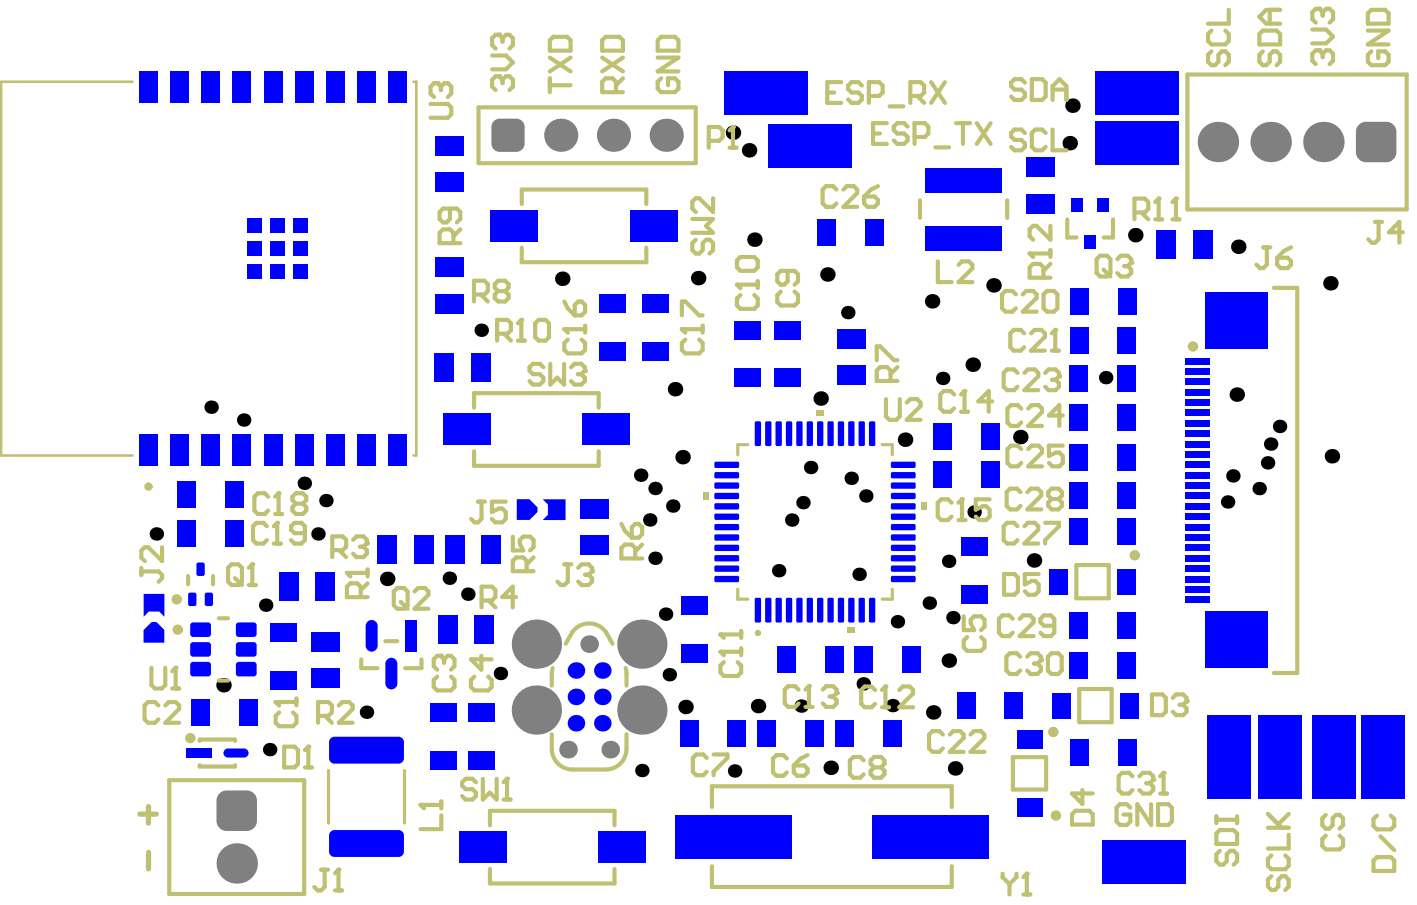
[picture p135: page 2]
