ETML-ES-SLO/PRJ_2409_Surveillance_T_H_Frigo/doc/Annexes/Annexes non triés/Annexe F.2_2409_MesureTH_RefrigerateurCongelateur_V1_Draftsman.PDF

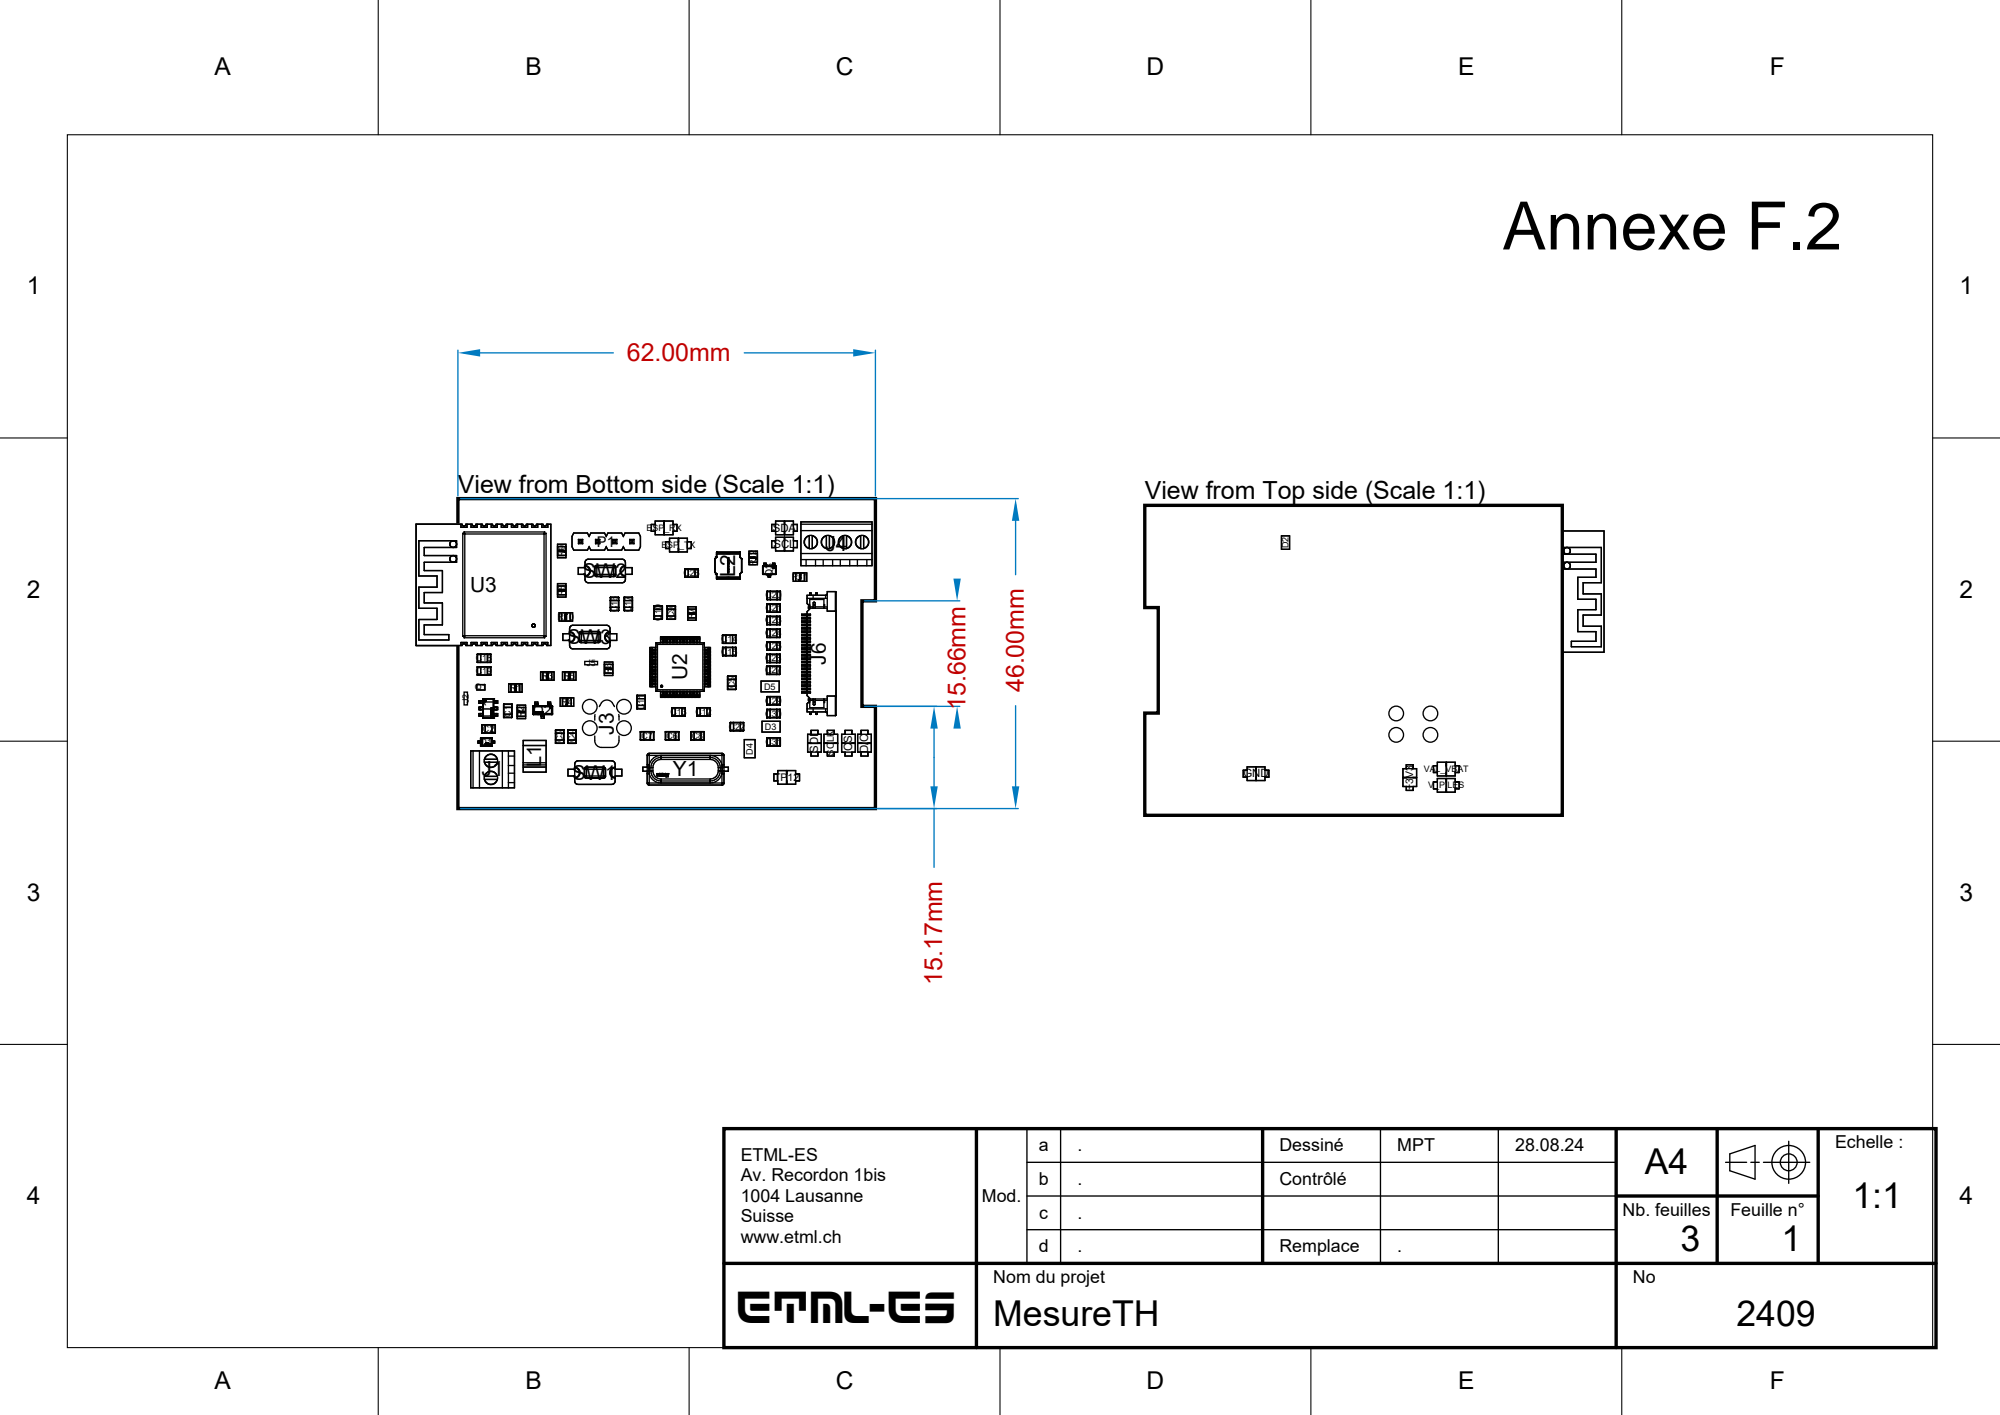
[picture p136: page 1]

View from Bottom side (Scale 1:1)

View from Top side (Scale 1:1)

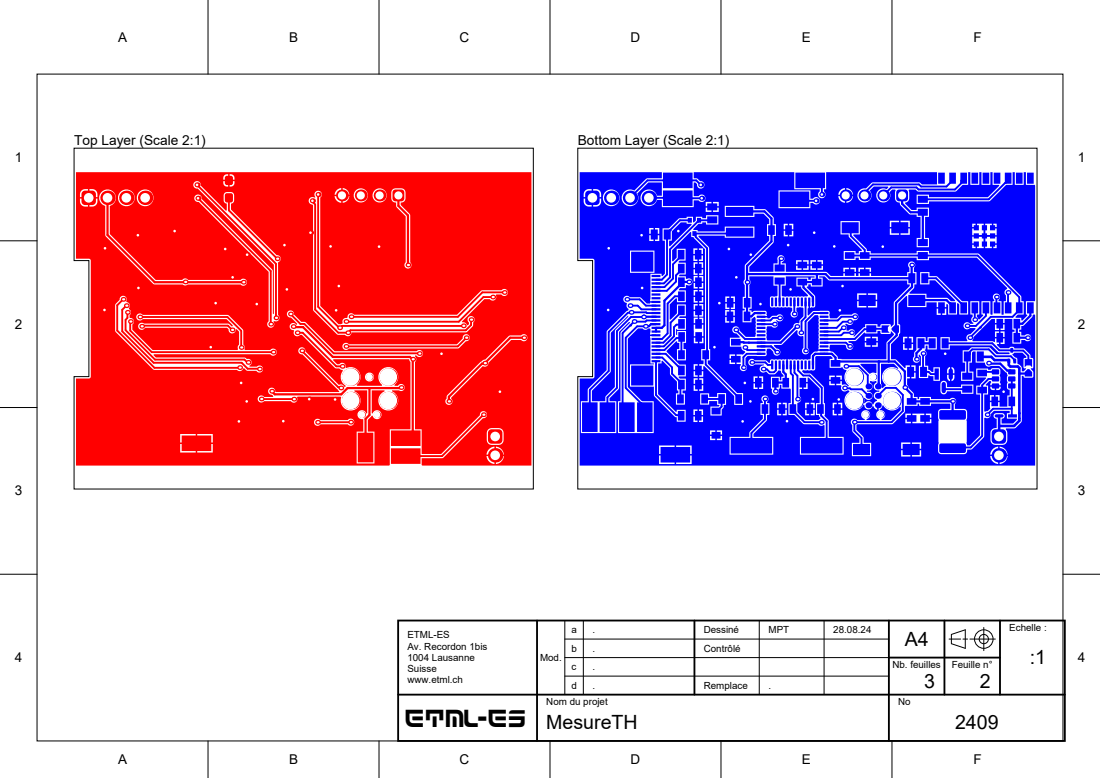
[picture p137: page 2]

ETML-ES Av. Recordon 1bis 1004 Lausanne Suisse www.etml.ch | Mod. | a | . | Dessiné | MPT | 28.08.24 | A4 | | Echelle : 1:1

b | . | Contrôlé
c | . | | | | Nb. feuilles 3 | Feuille n° 2
d | . | Remplace | .
Nom du projet | | | | | | No

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

b | . | Contrôlé
c | . | | | | Nb. feuilles 3 | Feuille n° 3
d | . | Remplace | .
Nom du projet | | | | | | No
