ETML-ES-SLO/PRJ_2409_Surveillance_T_H_Frigo/(list of files, drawings)

Other design files:
hard/2409_MesureTH_RefrigerateurCongelateur_V1/2409_MesureTH_RefrigerateurCongelateur_6C_2L.PcbDoc
hard/2409_MesureTH_RefrigerateurCongelateur_V1/2409_MesureTH_RefrigerateurCongelateur_V1.PrjPcb
hard/2409_MesureTH_RefrigerateurCongelateur_V1/Composants_Projet_2409.SchLib
hard/2409_MesureTH_RefrigerateurCongelateur_V1/E-paper.SchDoc
hard/2409_MesureTH_RefrigerateurCongelateur_V1/Footprint_Projet_2409.PcbLib
hard/2409_MesureTH_RefrigerateurCongelateur_V1/Microcontrôleur et capteur temp.SchDoc
hard/2409_MesureTH_RefrigerateurCongelateur_V1/Module ESP32.SchDoc
hard/2409_MesureTH_RefrigerateurCongelateur_V1/Power_Supply.SchDoc
hard/2409_MesureTH_RefrigerateurCongelateur_V1/Schéma bloc.SchDoc
