ETML-ES-SLO/PRJ_2409_Surveillance_T_H_Frigo/soft/Firmware/STM32/2409_MesureTH_V1/Core/Src/main.c

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
/* Includes ------------------------------------------------------------------*/
#include "main.h"

/* USER CODE BEGIN Includes */
#include <stdbool.h>
//#include "stm32f0xx.h"
#include "mesures.h"
#include "affichage.h"
#include "gestionBatterie.h"
#include "communication.h"
#include "sommeil.h"
#include "EPD_2in13_V4.h" // TEMP
/* USER CODE END Includes */

ADC_HandleTypeDef hadc;

I2C_HandleTypeDef hi2c2;

RTC_HandleTypeDef hrtc;

SPI_HandleTypeDef hspi1;

TIM_HandleTypeDef htim6;

UART_HandleTypeDef huart1;

/* USER CODE BEGIN PV */

EtatSTM etatSTM = INITIALISATION;

// Variables mesures
Mesures mesures;

// https://www.arduino.cc/reference/en/language/variables/data-types/array/
DefinitionValeur valeursServeur[] = {
	{ "seuilTemperatureMin", 2 },
  { "seuilTemperatureMax", 8 },
  { "ecartTemperature", 1 },
  { "seuilHumiditeMin", 30 },
  { "seuilHumiditeMax", 60 },
  { "ecartHumidite", 5},
};

// Variables affichage
bool rafraichirEPaper = false;
bool receptionTramesEspTermine = false;

// Variables batterie
InfoBatterie infoBatterie;

/* USER CODE END PV */

void SystemClock_Config(void);
static void MX_GPIO_Init(void);
static void MX_ADC_Init(void);
static void MX_I2C2_Init(void);
static void MX_SPI1_Init(void);
static void MX_USART1_UART_Init(void);
static void MX_TIM6_Init(void);
static void MX_RTC_Init(void);
/**
  * @brief  The application entry point.
  * @retval int
  */
int main(void)
{

  /* MCU Configuration--------------------------------------------------------*/

  /* Reset of all peripherals, Initializes the Flash interface and the Systick. */
  HAL_Init();

  /* Configure the system clock */
  SystemClock_Config();

  /* Initialize all configured peripherals */
  MX_GPIO_Init();
  MX_ADC_Init();
  MX_I2C2_Init();
  MX_SPI1_Init();
  MX_USART1_UART_Init();
  MX_TIM6_Init();
  MX_RTC_Init();
  /* Infinite loop */
  /* USER CODE BEGIN WHILE */
  while (1)
  {
    /* USER CODE END WHILE */

    /* USER CODE BEGIN 3 */
			
		switch(etatSTM)
		{
			case INITIALISATION:
				Initialisation(); // Initialisation au lancement du STM
				etatSTM = RECEPTION; // Pret à recevoir les données de la part de l'ESP
				break;
			case RECEPTION:
				
				// Note: la fréquence d'exécution de l'état RECEPTION est lié au timeout de la réception UART (define UART_TIMEOUT)
				ReceptionnerTrameUART(&huart1, valeursServeur);
				
				// On vérifie que receptionTramesEspTermine pour être sûr qu'on a bien été réveillé par l'ESP
				// On vérifie que HAL_GPIO_ReadPin(REVEIL_GPIO_Port, REVEIL_Pin) est GPIO_PIN_RESET pour être sûr que l'ESP à fini d'envoyer ses trames UART
				if(receptionTramesEspTermine == true && HAL_GPIO_ReadPin(REVEIL_GPIO_Port, REVEIL_Pin) == GPIO_PIN_RESET)
				{
					receptionTramesEspTermine = false;
					etatSTM = VERIFIER_BATTERIE; // Passage à l'étape suivante
				}
				break;
			case VERIFIER_BATTERIE:
			{
				bool besoinMesurerEtatBatterie = GestionCheckBatterie(&hadc, &htim6, &infoBatterie);			
				if(besoinMesurerEtatBatterie == true)
				{
					etatSTM = MESURER_BATTERIE; // Une mesure de l'état de la batterie est nécessaire
				}
				else
				{
					etatSTM = MESURER_SONDE;
				}
				break;
			}
			case MESURER_BATTERIE:
			{
				// Attente que le compteur décrémenté par l'interruption timer atteigne 0 (délai entre activation transistor et mesure)
				if(infoBatterie.compteurCheckBatterie <= 0)
				{
					Etat nouvelEtatBatterie = MesurerEtatBatterie(&hadc, &htim6, &infoBatterie); // Procéder à la mesure de l'état de la batterie		
					if(nouvelEtatBatterie != infoBatterie.etatBatterie)
					{
						infoBatterie.etatBatterie = nouvelEtatBatterie;
						EnvoyerTrameUART(&huart1, ETAT_BATTERIE, infoBatterie.etatBatterie); // Indiquer à l'ESP que l'état de la batterie à changé
					}
					etatSTM = MESURER_SONDE;
				}
				break;		
			}
			case MESURER_SONDE:
			{
				Etat nouvelEtatSeuils = EffectuerMesuresSonde(&hi2c2, &mesures, valeursServeur); // Procéder aux mesures de la température et de l'humidité
				if(nouvelEtatSeuils != mesures.etatSeuils)
				{
					mesures.etatSeuils = nouvelEtatSeuils;
					EnvoyerTrameUART(&huart1, ETAT_SEUILS, mesures.etatSeuils); // Indiquer à l'ESP que l'état de l'alarme à changé
				}		
				
				// Indiquer à l'ESP qu'on a fini d'envoyer les trames UART pour qu'il puisse se rendormir (si ne l'est pas déjà)
				HAL_GPIO_WritePin(ALARME_GPIO_Port, ALARME_Pin, GPIO_PIN_RESET); 
						
				// Si un rafraichissement de l'écran est nécessaire
				if(rafraichirEPaper == true)
				{
					etatSTM = RAFRAICHIR_EPAPER;				
				}
				else
				{
					etatSTM = SOMMEIL;
				}
				
				break;
			}			
			case RAFRAICHIR_EPAPER:				
				rafraichirEPaper = false;
				AffichageEPaper(&mesures, valeursServeur); // Procéder au rafraichissement de l'écran
				etatSTM = SOMMEIL;
				break;
			case SOMMEIL:
				EntrerModeSommeil();
				etatSTM = REVEIL;
				break;
			case REVEIL:
				etatSTM = RECEPTION;
				break;
		}	
  }
  /* USER CODE END 3 */
}

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
/* USER CODE BEGIN 4 */

////---------------------------------------------------------------------------------	

//// Fonction Initialisation
//// Description: Logique utilisée pour initialiser le système (initialisation des variables, calibration ADC, initialisation de la gestion du mode sommeil)
//// Entrées: -
//// Sorties: -
void Initialisation()
{
	mesures.etatSeuils = INDEFINI; // Pour s'assurer qu'un changement d'état de seuils aura bien lieu au lancement du programme
	
	infoBatterie.etatBatterie = INDEFINI; // Pour s'assurer qu'un changement d'état de batterie aura bien lieu au lancement du programme
	infoBatterie.compteurCheckBatterie = 0; // Pour s'assurer qu'une vérification de l'état de la  batterie ait lieu au lancement du programme
		
	HAL_ADCEx_Calibration_Start(&hadc); // Calibration ADC (utilisé pour vérifier l'état de la batterie)
	
	InitialiserGestionSommeil();	
}

//// Fonction HAL_TIM_PeriodElapsedCallback: interruption Timer
//// Description: fonction d'interruption du timer (délai entre activation transistor et mesure de l'état de la batterie)
//// Entrées: Pointeur:TIM_HandleTypeDef htim
//// Sorties: -
void HAL_TIM_PeriodElapsedCallback(TIM_HandleTypeDef *htim)
{
	// Decompte du compteur utilisé pour le délai entre l'activation du transistor et la mesure de l'état de la batterie
	if(etatSTM == MESURER_BATTERIE)
	{
		if(infoBatterie.compteurCheckBatterie > 0) 
		{
			infoBatterie.compteurCheckBatterie--;		
		}
		
	// Quand le compteur vaudra 0
	// Ce sera le moment de mesurer la tension de la batterie (à la prochaine exécution de la boucle main)
	}
}

//// Fonction EXTI4_15_IRQHandler: interruption pins GPIO
//// Description: fonction d'interruptioin de la pin utilisée par l'ESP pour réveiller le STM
//// Entrées: -
//// Sorties: -
void EXTI4_15_IRQHandler(void) 
{
	if(HAL_GPIO_ReadPin(REVEIL_GPIO_Port, REVEIL_Pin) == GPIO_PIN_SET)
	{		
		receptionTramesEspTermine = true; // Indique que l'ESP à fini d'envoyer ses éventuelles trames UART
	}
	
	// Pour s'assurer que l'état de l'interruption soit bien réinitialisé
	HAL_NVIC_ClearPendingIRQ(EXTI4_15_IRQn);
	__HAL_GPIO_EXTI_CLEAR_FLAG(GPIO_PIN_5);
}

/* USER CODE END 4 */
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
