ETML-ES-SLO/PRJ_2409_Surveillance_T_H_Frigo/soft/Firmware/STM32/2409_MesureTH_V1/Core/Inc/main.h

#define WKUP_ESP_Pin GPIO_PIN_13
#define WKUP_ESP_GPIO_Port GPIOC
#define RST_Pin GPIO_PIN_1
#define RST_GPIO_Port GPIOA
#define DC_Pin GPIO_PIN_2
#define DC_GPIO_Port GPIOA
#define BUSY_Pin GPIO_PIN_3
#define BUSY_GPIO_Port GPIOA
#define SPI_CS_Pin GPIO_PIN_4
#define SPI_CS_GPIO_Port GPIOA
#define VAL_VBAT_Pin GPIO_PIN_6
#define VAL_VBAT_GPIO_Port GPIOA
#define LED_RED_Pin GPIO_PIN_14
#define LED_RED_GPIO_Port GPIOB
#define EN_VBAT_Pin GPIO_PIN_10
#define EN_VBAT_GPIO_Port GPIOA
#define ALARME_Pin GPIO_PIN_3
#define ALARME_GPIO_Port GPIOB
#define ESP_EN_Pin GPIO_PIN_8
#define ESP_EN_GPIO_Port GPIOB
#define DIN_Pin GPIO_PIN_7
#define DIN_GPIO_Port GPIOA
#define SCK_Pin GPIO_PIN_5
#define SCK_GPIO_Port GPIOA
#define REVEIL_Pin GPIO_PIN_5
#define REVEIL_GPIO_Port GPIOB
