ETML-ES-SLO/PRJ_2409_Surveillance_T_H_Frigo/soft/Firmware/STM32/2409_MesureTH_V1/Communication/communication.h

/* ************************************************************************** */
/** Descriptive File Name

  @Company
    ETML-ES

  @File Name
    communication.h

  @Auteurs
    - Perret Mélissa

  @Description
    Fonctions liées à la communication ESP/STM
 */
/* ************************************************************************** */



#ifndef _COMMUNICATION_H
#define _COMMUNICATION_H


/* ************************************************************************** */
/* ************************************************************************** */
/* Section: Included Files                                                    */
/* ************************************************************************** */
/* ************************************************************************** */

/* This section lists the other files that are included in this file.
 */
 
 #include "main.h" // pour DefinitionValeur
 

#ifdef __cplusplus
extern "C" {
#endif

// *****************************************************************************
// *****************************************************************************
// Section: Global Data
// *****************************************************************************
// *****************************************************************************

#define TAILLE_BUFFER 50 // Taille du tableau utilisé pour stocker les données UART reçues
#define UART_RECEPTION_TIMEOUT_MS 3000 // Timeout lors de la réception UART
#define DELAI_ENVOIE_TRAME_MS 1000 // Délai entre le réveil de l'ESP et l'envoie de trame pour s'assurer que l'ESP est prêt à recevoir les trames


/* ************************************************************************** */
/* ************************************************************************** */
/* Section: Constants                                                         */
/* ************************************************************************** */
/* ************************************************************************** */

// *****************************************************************************
// *****************************************************************************
// Section: Prototypes
// *****************************************************************************
// *****************************************************************************
//---------------------------------------------------------------------------------	

void ReceptionnerTrameUART(UART_HandleTypeDef* huart, DefinitionValeur valeursServeur[]);
void EnvoyerTrameUART(UART_HandleTypeDef* huart, uint8_t index, double valeur);


#ifdef __cplusplus
}
#endif

#endif /* _COMMUNICATION_H */
