ETML-ES-SLO/PRJ_2409_Surveillance_T_H_Frigo/soft/Firmware/STM32/2409_MesureTH_V1/Sommeil/sommeil.h

/* ************************************************************************** */
/** Descriptive File Name

  @Company
    ETML-ES

  @File Name
    sommeil.h

  @Auteurs
    - Perret Mélissa

  @Description
    Fonctions liées à l'entrée et sortie du mode sommeil
 */
/* ************************************************************************** */



#ifndef _SOMMEIL_H
#define _SOMMEIL_H


/* ************************************************************************** */
/* ************************************************************************** */
/* Section: Included Files                                                    */
/* ************************************************************************** */
/* ************************************************************************** */

/* This section lists the other files that are included in this file.
 */

#ifdef __cplusplus
extern "C" {
#endif

// *****************************************************************************
// *****************************************************************************
// Section: Global Data
// *****************************************************************************
// *****************************************************************************

/* ************************************************************************** */
/* ************************************************************************** */
/* Section: Constants                                                         */
/* ************************************************************************** */
/* ************************************************************************** */

// *****************************************************************************
// *****************************************************************************
// Section: Prototypes
// *****************************************************************************
// *****************************************************************************
//---------------------------------------------------------------------------------	

void InitialiserGestionSommeil(void);
void EntrerModeSommeil(void);	


#ifdef __cplusplus
}
#endif

#endif /* _SOMMEIL_H */
