ETML-ES-SLO/PRJ_2409_Surveillance_T_H_Frigo/soft/Firmware/ESP32/2409_ESP_V1/Discord.h

/* ************************************************************************** */
/** Descriptive File Name

  @Company
    ETML-ES

  @File Name
    Discord.h

  @Auteurs
    - Perret Mélissa

  @Description
    Fonctions liées à l'envoi de notifications Discoprd
 */
/* ************************************************************************** */


#ifndef _DISCORD_H
#define _DISCORD_H


// URL pour envoyer les notifications Discord
// Comment récupérer l'URL du webhook: https://support.discord.com/hc/en-us/articles/228383668-Intro-to-Webhooks
#define DISCORD_WEBHOOK_URL "https://discord.com/api/webhooks/1287209194017128478/7BPCUgn1GDfLxNcpws1uXw25Ld2WCcd67s2fNQfORzKD3JV0i-wap5MRjXm4DbqWoZMb"


#endif /* _DISCORD_H */
