ETML-ES-SLO/PRJ_2409_Surveillance_T_H_Frigo/soft/Firmware/STM32/2409_MesureTH_V1/e-Paper/affichage.h

/* ************************************************************************** */
/** Descriptive File Name

  @Company
    ETML-ES

  @File Name
    affichage.h

  @Auteurs
    - Perret Mélissa

  @Description
    Fonctions liée à l'affichage E-paper
 */
/* ************************************************************************** */



#ifndef _AFFICHAGE_H_
#define _AFFICHAGE_H_


/* ************************************************************************** */
/* ************************************************************************** */
/* Section: Included Files                                                    */
/* ************************************************************************** */
/* ************************************************************************** */

/* This section lists the other files that are included in this file.
 */
 
#include "mesures.h" // pour Mesures
 

#ifdef __cplusplus
extern "C" {
#endif

// *****************************************************************************
// *****************************************************************************
// Section: Global Data
// *****************************************************************************
// *****************************************************************************

/* ************************************************************************** */
/* ************************************************************************** */
/* Section: Constants                                                         */
/* ************************************************************************** */
/* ************************************************************************** */

#define NOMBRE_DECIMALES_MESURES 2 // Nombre de décimales affichées sur l'écran pour les valeurs liées au mesure


// *****************************************************************************
// *****************************************************************************
// Section: Prototypes
// *****************************************************************************
// *****************************************************************************
//---------------------------------------------------------------------------------	

int AffichageEPaper(Mesures* mesures, DefinitionValeur valeursServeur[]);

#ifdef __cplusplus
}
#endif

#endif /* _AFFICHAGE_H_ */
