ETML-ES-SLO/PRJ_2409_Surveillance_T_H_Frigo/(commit log)

2024-09-24 TD 2409 - Version Finale - MPT
    [2409_Base_CapteurTemperature_V1.SLDPRT, 2409_BoitierPCB_Base_V1.SLDPRT, 2409_BoitierPCB_CASE_V1.SLDDRW, 2409_Case_CapteurTemperature_V1.SLDDRW, 2409_Couvercle_BoitierPCB_V1.SLDDRW, 2409_Couvercle_BoitierPCB_V1.SLDPRT, 2409_Couvercle_CapteurTemperature_V1.SLDDRW, 2409_Couvercle_CapteurTemperature_V1.SLDPRT]
2024-09-24 Update Wifi.h
    Correction des paramètres pour la connexion wifi de l'école
    [Wifi.h]
